raden-ayu44/embedded-systems-finpro/pcb/gambar/pcb-3d-atas-hgd-v1.png

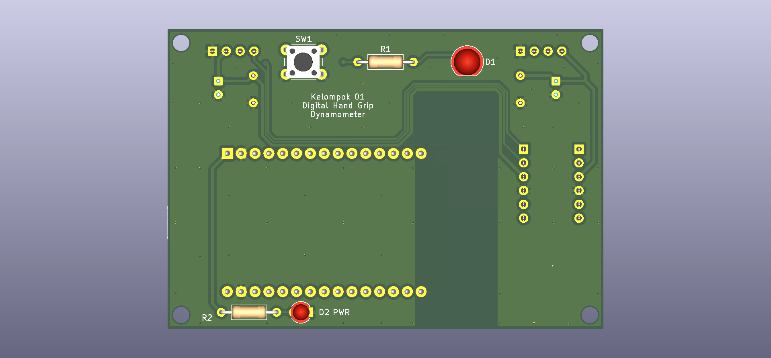
pcb/gambar/pcb-3d-atas-hgd-v1.png
