raden-ayu44/embedded-systems-finpro/datasheet/pdf/README.md

# Datasheet PDFs

Copies of cited datasheets, kept for convenience. Rights stay with the manufacturers and publishers. Each file is cited in [`../datasheet-library.md`](../datasheet-library.md) by the code in the second column.

| File | Cited as |
|---|---|
| `CZL601_OIML_datasheet.pdf`, `CZL601_Datasheet.pdf`, `CZL601_Brochure.pdf`, `GJ_Impex_CZL-601_load_cell.pdf` | DS-LC1 (CZL 601 load cell), [6] |
| `HX711_datasheet_Avia.pdf` | DS-HX1, [2] |
| `HX711_PSoC_Creator_component_datasheet_v0_0_B.pdf` | DS-HX1, [3] |
| `SparkFun_HX711_Load_Cell_skema.pdf` | HX711 module schematic (comparison) |
| `ESP32-WROOM-32D_32U_datasheet.pdf` | DS-ESP1, [7] |
| `esp-dev-kits_ESP32-DevKitC_halaman.pdf` | DS-ESP2, [8] |
| `ESP32_series_datasheet.pdf` | [10] |
| `HS1602A_datasheet.pdf` | DS-LCD1, [12] |
| `PCF8574_PCF8574A_datasheet.pdf` | DS-I2C1, [13] |
| `Adafruit_I2C_SPI_LCD_backpack.pdf` | [14] |

Vendor listings and web pages are not included; they are listed by name in the datasheet notes.
