raden-ayu44/embedded-systems-finpro/pcb/log-kerja-kicad-hgd.md

---
title: Log Kerja KiCad - PCB hgd-v1

---

# Log Kerja KiCad - PCB hgd-v1 (v3)
**Proyek akhir - embedded system**

> Catatan langkah kerja KiCad yang dikerjakan penulis sendiri, dengan bukti hasil tiap langkah. Kolom "Pemeriksaan" berisi hasil cek oleh alat AI (Claude) terhadap berkas atau tangkapan layar; pekerjaan di KiCad seluruhnya oleh penulis. Desain: [desain-pcb-hgd.md](desain-pcb-hgd.md); berkas: [kicad/proyek/](kicad/proyek/); induk: [catatan-proyek-hgd.md](../catatan-proyek-hgd.md).

---

| # | Tanggal | Langkah | Yang dikerjakan | Hasil | Pemeriksaan |
|---|---|---|---|---|---|
| 1 | 17 Okt. 2026 | Assign Footprints (Tools > Assign Footprints) | 14 simbol diberi footprint: C1, C4 `C_Disc_D7.0mm_W2.5mm_P5.00mm`; C2, C3 `CP_Radial_D5.0mm_P2.50mm`; D1 `LED_D5.0mm`; D2 `LED_D3.0mm`; J1, J2 `PinSocket_1x04_P2.54mm_Vertical`; J3, J4 `PinSocket_1x06_P2.54mm_Vertical`; R1, R2 `R_Axial_DIN0207_L6.3mm_D2.5mm_P10.16mm_Horizontal`; SW1 `SW_PUSH_6mm_H13mm`; U2 `ESP32-DEVKIT-V1:MODULE_ESP32_DEVKIT_V1` (SnapEDA) | Semua simbol punya footprint | Cocok dengan berkas papan. BOM dari KiCad tidak memuat 2 soket betina 1x15 untuk DevKit dan modul yang dicolok (HX711, LCD + backpack, level shifter, load cell); tambahkan manual di BOM |
| 2 | 17 Okt. 2026 | ERC (Inspect > Electrical Rules Checker) | 24 tanda no-connect pada pin tak terpakai (20 pin U2; J3 dan J4 pin 5-6); `PWR_FLAG` di GND; 7 peringatan `lib_symbol_mismatch` dikecualikan | **0 error, 0 warning**, 7 pengecualian (sebelumnya 28 error, 7 warning) | Pengecualian beralasan: simbol J1-J4, C1, C4, SW1 sudah diubah (nama pin); memperbarui dari pustaka akan menghapus nama pin itu |
| 3 | 17 Okt. 2026 | Page Settings skema (File > Page Settings) | Title "Hand Grip Dynamometer", Company "Kelompok 01", Revision 1, Issue Date 2026-10-17 | Title block terisi; berkas skema di repo diperbarui | Tidak ada nama orang dan jalur lokal di berkas skema |
| 4 | 17 Okt. 2026 | Simpan skema ke repo | Berkas `hgd-v1.kicad_sch` hasil langkah 1-3 disimpan dan diserahkan untuk repo | [kicad/proyek/hgd-v1.kicad_sch](kicad/proyek/hgd-v1.kicad_sch) di PR #5 (commit oleh Claude) | Berkas sama dengan yang diserahkan; tanpa jalur lokal |
| 5 | 17 Okt. 2026 | Plot Gerber dan bor (File > Fabrication Outputs) | **Plot:** format Gerber, folder `gerber\`; lapis F.Cu, B.Cu, F.Silkscreen, B.Silkscreen, F.Mask, B.Mask, Edge.Cuts; opsi umum: Subtract soldermask from silkscreen, Indicate DNP (cross-out), Check zone fills before plotting, tanpa drawing sheet, skala 1:1; opsi Gerber: Use Protel filename extensions, Generate Gerber job file, format koordinat 4.6 (mm), Use extended X2 format, Include netlist attributes. **Bor:** Excellon, metrik (mm), desimal, absolut; PTH dan NPTH di berkas terpisah; peta bor PDF | 12 berkas (19:44-19:45): 7 Gerber, job file (Revision 1), `PTH.drl`, `NPTH.drl`, 2 peta bor PDF; DRC 0 pelanggaran, 4 pengecualian | Outline 80 x 55 mm; 129 PTH (70 kaki komponen, 59 via), 4 NPTH Ø3,0; pour GND di kedua lapis, area antena kosong; silkscreen tim ada; tanpa jalur lokal. Belum dicek di viewer fabrikator |
| 6 | 17 Okt. 2026 | Cek di viewer fabrikator (JLCPCB, juga ekspor SVG viewer PCBWay) | ZIP Gerber diunggah ke penawaran daring JLCPCB (tanpa memesan); pratinjau atas dan bawah diperiksa; SVG lapis dari viewer PCBWay diunduh | JLCPCB: "Detected 2 layer board of 55x80mm", dimensi 80 x 55, 2 lapis, FR-4. Pratinjau sama dengan papan: outline persegi, H1-H4, baris DevKit dan J1-J4, pour GND kedua sisi dengan jalur antena kosong, silkscreen tim dan D2 PWR terbaca | Pratinjau cocok dengan berkas papan; viewBox SVG PCBWay 80 x 55 mm pada koordinat papan yang sama |
| 7 | 17 Okt. 2026 | Title block papan, salinan 3D, dan ekspor STEP | Page Settings papan diisi (Title, Company, Revision 1, tanggal); salinan `hgd-v1-verbatim.kicad_pcb` dengan dua soket 1x15 di pad U2; STEP diekspor dari salinan itu (File > Export > STEP) | `hgd-v1.kicad_pcb`, `hgd-v1-verbatim.kicad_pcb`, `hgd-v1.step` di [kicad/proyek/](kicad/proyek/) | Berkas papan utama hanya berbeda di title block dari versi sebelumnya; tanpa jalur lokal di ketiga berkas. Salinan verbatim punya lubang ganda di pad U2, jadi Gerber tetap dari `hgd-v1.kicad_pcb` |
| 8 | 26 Okt. 2026 | Assign Footprints, tangkapan layar | Jendela Assign Footprints dibuka lagi dan ditangkap | 14 penetapan sama dengan langkah 1; tangkapan [gambar/assign-footprint-hgd-v1.png](gambar/assign-footprint-hgd-v1.png), daftar teks di Bagian 8.1a [desain-pcb-hgd.md](desain-pcb-hgd.md) | Cocok dengan footprint di berkas papan |
| 9 | 18-19 Okt. 2026 | Judul dan silkscreen tim | Teks silkscreen tim di sisi atas dan bawah menjadi "Kelompok 01 / Digital Hand Grip / Dynamometer" (sama dengan judul proposal); Page Settings skema dan papan: Title "Digital Hand Grip Dynamometer", Company "Kelompok 01", Revision 1 tetap (tanggal di title block: skema 2026-10-19, papan 2026-10-26) | Title block dan silkscreen diperbarui | Skema hanya berubah di title block (judul dan tanggal); rangkaian dan netlist sama dengan 17 Okt. |
| 10 | 26 Okt. 2026 | ERC ulang dan PDF skema | ERC dijalankan lagi; skema dicetak ke PDF | **0 error, 0 warning**, 7 pengecualian (sama dengan langkah 2); tangkapan [gambar/erc-skema-hgd-v1.png](gambar/erc-skema-hgd-v1.png); PDF [kicad/pdf/skema-hgd-v1.pdf](kicad/pdf/skema-hgd-v1.pdf) | Metadata PDF tanpa nama orang (judul "Print Schematic", penulis kosong) |
| 11 | 26 Okt. 2026 | Belokan 45°, via, stackup | Tiga belokan siku (90°) di tengah jalur dibuat 45° (satu di jalur GND, sulit terlihat karena warnanya menyatu dengan pour); beberapa via digeser menjauhi tepi papan setelah cek JLCDFM (langkah 13); stackup papan diisi (FR4, 1,6 mm, tembaga 35 µm); DRC diulang | DRC: **0 error, 0 warning**, 3 pengecualian (footprint U2, C2, C3 berbeda dari salinan pustaka), 0 tak tersambung, 0 beda skema; 5 uji diabaikan. Tangkapan [gambar/drc-pcb-hgd-v1.png](gambar/drc-pcb-hgd-v1.png), [gambar/drc-uji-diabaikan-hgd-v1.png](gambar/drc-uji-diabaikan-hgd-v1.png) | Posisi 18 footprint sama dengan 17 Okt.; dibanding berkas 17 Okt. (termasuk perubahan langkah 9): segmen jalur 200 → 186; via 59 → 58 (56 GND + 2 sinyal). Empat sudut 90° yang tersisa tepat di pad. Pengecualian spoke thermal pad 2 U2 (langkah 5) tidak ada lagi |
| 12 | 26 Okt. 2026 | Plot Gerber dan bor ulang | Setelan sama dengan langkah 5 (KiCad 10.0.6), ZIP `Gerber_Kelompok-01_hgd-v1.zip` | 12 berkas (20:35): 7 Gerber, job file (Revision 1), `PTH.drl`, `NPTH.drl`, 2 peta bor PDF; ukuran di job file 80,05 x 55,05 mm (termasuk tebal garis outline), 2 lapis, 1,6 mm; aturan desain: jalur minimum 0,3 mm, jarak pad/jalur 0,2 mm, jarak ke pour 0,5 mm | Folder keluaran di berkas papan dan proyek menunjuk folder lokal di luar repo; di salinan repo dikembalikan ke `gerber/`. Gerber belum masuk repo (menunggu persetujuan) |
| 13 | 26 Okt. 2026 | Cek DFM di JLCDFM | ZIP Gerber diunggah ke viewer JLCDFM, analisis DFM dijalankan, laporan PDF diunduh | Terbaca 2 lapis, 80 x 55 mm; 0 sudut tajam; jarak antarjalur minimum 0,2 mm (baik); cincin tembaga lubang 0,25 mm (baik); solder mask dan lubang bor tanpa masalah. Silkscreen: 5 "bahaya" + 2 peringatan jarak tulisan ke pad (minimum 0,09 mm) dan 80 peringatan tebal garis tulisan (0,12 mm), dari garis bawaan footprint pustaka KiCad, bukan tulisan tim; tidak memengaruhi fungsi listrik | Dicek sebelum dan sesudah perbaikan langkah 11. Pratinjau sama dengan papan (outline, H1-H4, soket, silkscreen). Tangkapan dan laporan disimpan di luar repo |
| 14 | 26 Okt. 2026 | Render papan dan 3D | Tampak atas dan bawah, papan saja dan model 3D | [gambar/pcb-atas-hgd-v1.png](gambar/pcb-atas-hgd-v1.png), [pcb-bawah](gambar/pcb-bawah-hgd-v1.png), [3D atas](gambar/pcb-3d-atas-hgd-v1.png), [3D bawah](gambar/pcb-3d-bawah-hgd-v1.png) | STEP 26 Okt. diekspor dari papan utama, jadi tanpa dua soket 1x15 DevKit; soket tidak memengaruhi desain housing, jadi STEP ini menggantikan `hgd-v1.step` lama dan salinan `hgd-v1-verbatim.kicad_pcb` dihapus (27 Okt. 2026) |
| 15 | 27 Okt. 2026 | Gambar penempatan diperbarui | Gambar SVG tiga panel (gabungan, F.Cu, B.Cu + silkscreen bawah) dibuat ulang dari berkas papan 26 Okt. oleh alat AI (Claude); keterangan ditulis dalam bahasa Indonesia, istilah teknis dalam bahasa Inggris | [gambar/penempatan-pcb-hgd.svg](gambar/penempatan-pcb-hgd.svg) | Dicek terhadap `hgd-v1.kicad_pcb`: 186 segmen jalur (posisi, lapis, lebar), 58 via, 70 pad, 4 NPTH, dan teks silkscreen kedua sisi sama dengan berkas |
| 16 | 12 Nov. 2026 | Perbaikan silkscreen footprint dan D2 | Garis silkscreen footprint pustaka yang terlalu dekat pad dihapus (D1: lingkaran; D2: 2 garis, 2 busur; R1, R2: 2 garis masing-masing); D2 digeser 0,52 mm ke kanan dengan dua segmen jalur GND ke katodenya; tiga via jahit GND di tepi bawah digeser; uji `lib_footprint_mismatch` dan `lib_symbol_mismatch` diatur Ignore (pengecualian lama dihapus) | `hgd-v1.kicad_pcb`, `hgd-v1.kicad_pro` di [kicad/proyek/](kicad/proyek/) | Dibanding papan 26 Okt.: 18 footprint, hanya D2 berpindah (x 135,50 → 136,02); 186 segmen (2 berubah), 58 via (3 berpindah), pad lain dan Edge.Cuts sama. DRC ulang (kicad-cli): 0 pelanggaran, 0 tak tersambung, 0 beda skema; ERC ulang: 0 error, 0 warning. Folder keluaran di salinan repo dikembalikan ke `gerber/`, STEP ke `hgd-v1.step` |
| 17 | 12 Nov. 2026 | Plot Gerber dan bor ulang | Setelan sama dengan langkah 5 (KiCad 10.0.6), ZIP `Gerber_Kelompok-01_hgd-v1.zip` | 12 berkas (10:53): 7 Gerber, job file, `PTH.drl`, `NPTH.drl`, 2 peta bor PDF | Geometri dibandingkan dengan ekspor kicad-cli dari berkas papan yang sama: tembaga, mask, silkscreen, Edge.Cuts, 128 PTH, dan 4 NPTH sama (beda hanya nomor aperture dan waktu) |
| 18 | 12 Nov. 2026 | Cek DFM di JLCDFM | ZIP Gerber 12 Nov. diunggah, analisis DFM dijalankan, laporan PDF diunduh | 2 lapis, 8 x 5,5 cm; sudut tajam 0; jarak antarjalur 0,2 mm (baik); cincin tembaga 0,25 mm (baik); soldermask dan bor 0 temuan; silkscreen ke pad **0 temuan** (minimum 0,19 mm; 26 Okt.: 5 bahaya + 2 peringatan, minimum 0,09 mm); tebal garis silkscreen 76 peringatan (0,12 mm; 26 Okt.: 80) | Laporan disimpan di luar repo. Sisa peringatan tebal garis dari garis footprint pustaka, tidak memengaruhi fungsi listrik |

---

## Perubahan

| Versi | Tanggal | Perubahan |
|---|---|---|
| v3 | 12 Nov. 2026 | Langkah 16-18 (12 Nov. 2026): silkscreen footprint dirapikan, D2 digeser, uji beda-pustaka diatur ignore, Gerber ulang, cek JLCDFM |
| v2 | 27 Okt. 2026 | Langkah 8-14 (26 Okt. 2026): tangkapan Assign Footprints, judul dan silkscreen baru, ERC ulang dan PDF skema, belokan 45° dan stackup, Gerber ulang, cek JLCDFM, render; STEP baru menggantikan STEP dan salinan verbatim 17 Okt.; langkah 15 (27 Okt.): gambar penempatan papan akhir |
| v1 | 17 Okt. 2026 | Log pertama: langkah 1-7 |
