raden-ayu44/embedded-systems-finpro/sitasi/sitasi-hgd.md

---
title: Sitasi dan Daftar Pustaka - Hand Grip Dynamometer

---

# Sitasi dan Daftar Pustaka - Hand Grip Dynamometer (v1)
**Proyek akhir - embedded system**

> Teori buku dan temuan paper yang menjadi dasar keputusan, kode sitasi lokal, dan daftar pustaka gaya IEEE. Kode (M1, W1, V1, dst.) dipakai di semua dokumen proyek. Induk: [catatan-proyek-hgd.md](../catatan-proyek-hgd.md).

---

## 1. LIBRARY SITASI - TEORI BUKU & TEMUAN PAPER

*Parafrase setia (bukan kutipan verbatim) dari kedua buku teks, diterjemahkan ke Indonesia dengan analogi di beberapa titik. Temuan paper diinterpretasi. Cakupan dibatasi pada yang benar-benar jadi fondasi keputusan di dokumen ini - bagian buku/paper yang dibaca tapi tidak dipakai (misal fitur game Gotthelf, sensor FSR/IMU Becerra, amplifier AD627) sengaja tidak dimasukkan di sini (lihat Bagian 3 di [catatan-proyek-hgd.md](../catatan-proyek-hgd.md) untuk catatan "TIDAK diadopsi"-nya).*

**Konvensi sitasi lokal:** kode di kolom pertama tabel di bawah (M1, W1, V1, dst.) dipakai sebagai sitasi `(kode)` di seluruh dokumen proyek ini - ditulis menempel setelah klaim yang didukungnya, gaya IEEE. **Sistem ini TIDAK universal** - kode ini cuma berlaku di dokumen proyek ini sendiri, tidak bisa dipakai/dikenali di dokumen lain (beda dari sitasi [1], [2] ala panduan yang merujuk Daftar Pustaka baku). Kalau bagian dari catatan ini disalin ke dokumen formal nanti, kode `(kode)` ini perlu ditulis ulang jadi sitasi format resmi (APA/IEEE sesuai ketentuan dosen) merujuk ke daftar pustaka yang sebenarnya - bukan dibiarkan sebagai kode internal ini.

### 1.1 Marwedel, *Embedded System Design* (ed. 4, 2021)

| Kode | Isi (parafrase) | Asal |
|---|---|---|
| M1 | Statechart memperluas FSM datar dengan dua kemampuan: (a) state hierarkis - satu "superstate" bisa membungkus beberapa state di dalamnya, dan (b) orthogonal region - beberapa state bisa aktif bersamaan secara paralel. Transisi bisa digambar dari batas superstate itu sendiri (bukan dari tiap state anak satu-satu) dan otomatis berlaku untuk seluruh state di dalamnya - disebut interrupt transition. Analogi: seperti aturan "kalau alarm kebakaran berbunyi, semua orang di gedung keluar" - tidak perlu aturan terpisah per lantai/ruangan, cukup satu aturan di level gedung. | Bab 2, §2.4 Communicating Finite State Machines, §2.4.2 StateCharts |
| M2 | Embedded system didefinisikan sebagai sistem pemrosesan informasi yang tertanam ke dalam produk yang membungkusnya (bukan berdiri sendiri sebagai komputer umum). Tabel 1.2 membandingkan lewat 4 kriteria: arsitektur (kompak-heterogen vs tidak kompak-homogen), tujuan optimasi (energi/ukuran vs performa rata-rata), relevansi real-time (sering penting vs jarang), dan safety-critical (mungkin vs biasanya tidak). | Bab 1, Definisi 1.1 & Tabel 1.2 |
| M3 | Sensor mengubah besaran fisik (di sini: gaya tekan) jadi sinyal listrik analog. Karena sinyal analog kontinu tapi mikrokontroler memproses secara diskrit, dibutuhkan dua tahap diskritisasi: sample-and-hold (menangkap nilai sinyal pada satu momen dan menahannya stabil sesaat), lalu ADC (mengubah nilai yang ditahan itu jadi angka digital). Analogi: seperti memfoto air yang mengalir - kamera "menahan" satu momen (sample-and-hold) sebelum dicetak jadi gambar diam (ADC). | Bab 3, §3.2.1 Sensors, §3.2.2 Sample-and-Hold, §3.2.4 ADC |
| M4 | Kebalikan dari ADC - DAC mengubah sinyal digital jadi analog untuk menggerakkan aktuator. PWM adalah alternatif lebih murah dari DAC asli: sinyal digital dinyalakan-matikan sangat cepat dengan rasio (duty cycle) tertentu, dan secara rata-rata "terasa" seperti tegangan analog di antara 0 dan penuh oleh perangkat penerima (motor, mata manusia untuk LED). | Bab 3, §3.6.1 DAC, §3.6.3 Pulse-Width Modulation, §3.6.4 Actuators |
| M5 | Metrik kuantitatif seberapa jauh nilai hasil pengukuran menyimpang dari nilai sebenarnya: MAE (rata-rata selisih absolut), MSE (rata-rata selisih kuadrat - menghukum error besar lebih berat), RMSE (akar dari MSE, kembali ke satuan asli sehingga mudah diinterpretasi), SNR/PSNR (rasio sinyal terhadap noise). | Bab 5, §5.3 Quality Metrics |
| M6 | Dua metode analisis risiko formal. FMEA bekerja dari bawah ke atas: mendaftar tiap kemungkinan cara komponen gagal (mode kegagalan), efeknya ke sistem, lalu tingkat keparahan. FTA bekerja dari atas ke bawah: mulai dari satu kegagalan sistem yang tidak diinginkan, menelusuri kombinasi kegagalan komponen yang bisa menyebabkannya (pohon logika AND/OR). | Bab 5, §5.6.5 Fault Tree Analysis, Failure Mode, and Effect Analysis |

### 1.2 White, *Making Embedded Systems* (ed. 1, 2011) - rujukan panduan [3]

| Kode | Isi (parafrase) | Asal |
|---|---|---|
| W1 | Kontak tombol mekanik tidak berubah bersih dari 0 ke 1 saat ditekan - fisiknya bergetar (bouncing) beberapa milidetik, menyebabkan pembacaan digital berubah cepat berkali-kali padahal cuma satu tekanan. Solusi debounce software: catat waktu tiap kali sinyal berubah, abaikan perubahan berikutnya kalau terjadi dalam jendela waktu terlalu singkat sejak perubahan terakhir (dianggap bouncing, bukan tekanan baru). | Bab 4, "Momentary Button Press" |
| W2 | Pola desain di mana logika penanganan error (deteksi, pencatatan, pemulihan) dikumpulkan jadi satu modul/fungsi yang dipanggil dari berbagai titik program yang membutuhkan, alih-alih ditulis berulang di tiap tempat kode yang bisa gagal. Manfaat: konsistensi penanganan error di seluruh sistem, perubahan cukup di satu tempat kalau kebijakan error berubah. | Bab 3, "Dealing with Errors" - Error Handling Library pattern |
| W3 | Lima cara mengkodekan finite state machine di C: (1) State-Centric - percabangan besar berdasarkan state aktif; (2) State-Centric with Hidden Transitions - varian dengan transisi disembunyikan di dalam fungsi state; (3) Event-Centric - percabangan berdasarkan event masuk, bukan state aktif; (4) State Pattern - satu objek/struct per state dengan fungsi seragam (gaya OOP); (5) Table-Driven - tabel data yang memetakan (state saat ini + event) ke (state berikutnya + aksi), dieksekusi satu "engine" generik yang sama untuk semua state. Penulis merekomendasikan table-driven karena engine-nya reusable dan tiap baris tabel gampang diuji terpisah. | Bab 5, "State Machines" & "Choosing a State Machine Implementation" |
| W4 | Timer hardware terpisah dari prosesor utama yang me-reset sistem kalau tidak menerima sinyal "sistem sehat" ("kick"/"pet the dog") dalam batas waktu tertentu. Menangani kegagalan yang TIDAK bisa dipulihkan software sendiri (macet total/infinite loop) - bukan pengganti error handling normal. Tiga pola pemberian sinyal yang salah: (a) dari timer interrupt terpisah - membatalkan tujuan watchdog karena sistem tidak pernah reset walau macet; (b) di dalam fungsi delay - sinyal tersebar, area tanpa delay tidak terpantau; (c) disebar di banyak fungsi panjang - melemahkan pengawasan. Rekomendasi: satu titik sinyal saja, idealnya di ujung main loop. | Bab 5, "Watchdog" |
| W5 | Struktur data array berukuran tetap yang "melingkar" - begitu penuh, data baru menimpa data terlama. Cocok menyimpan N sampel terakhir dengan memori terprediksi dan konstan, tanpa menggeser seluruh isi array tiap ada data baru. | Bab 6, "Circular Buffers" |
| W6 | Dua pendekatan menghitung rata-rata data yang terus mengalir: cumulative average (rata-rata berjalan, diperbarui lewat rumus incremental tanpa menyimpan seluruh riwayat - hemat memori) versus menyimpan beberapa sampel terakhir lalu dirata-rata/dicari mediannya sekali di akhir (median lebih tahan outlier/noise ekstrem, tapi butuh memori menyimpan sampel). | Bab 9, "Taking an Average" & "Different Averages: Cumulative and Median" |
| W7 | Dua gaya arsitektur sistem embedded. Event-driven: sistem diam menunggu kejadian (interrupt, tombol) lalu bereaksi sesaat, kembali diam. Data-driven: sistem memproses aliran data yang datang terus-menerus (misal dari sensor) secara berulang. Kebanyakan sistem nyata adalah campuran keduanya - penulis menyarankan memisahkan dengan jelas bagian mana tergolong mana dalam satu desain. | Bab 6, "Data Handling" |

### 1.3 Vaishya et al. 2024 (J Health Pop & Nutrition)

| Kode | Isi (interpretasi) | Asal |
|---|---|---|
| V1 | Protokol pengukuran standar (Box 1): posisi duduk, bahu netral, siku ditekuk 90°, pergelangan tangan 0-30° dorsofleksi; kalibrasi alat sebelum mulai; instruksi verbal ke partisipan "remas sekuat dan selama mungkin sampai saya bilang berhenti (ketika jarum berhenti naik)"; tahan 3-5 detik; istirahat ~1 menit antar percobaan; 3 kali percobaan bergantian tangan. | Box 1 |
| V2 | Nilai klinis HGS datang dari pengukuran berulang dari waktu ke waktu untuk melihat tren, bukan dari satu kali pembacaan tunggal. | Bagian pembahasan utama |
| V3 | Relative HGS = HGS dibagi BMI, untuk menormalisasi perbedaan ukuran tubuh antar individu saat membandingkan kekuatan genggam. | Bagian pembahasan utama |
| V4 | Ambang "lemah" (sarkopenia) untuk HGS menurut berbagai badan kesehatan: EWGSOP2 (Eropa) <27kg pria/<16kg wanita; AWGS (Asia) <28kg pria/<18kg wanita; India (Sarco-CUBES) <27,5kg pria/<18kg wanita. Populasi sehat pada umumnya berada jauh di atas ambang ini. | Tabel 1 |

### 1.4 Ramadhani et al. 2019 (IJEEEMI)

| Kode | Isi (interpretasi) | Asal |
|---|---|---|
| R1 | Arsitektur: Arduino Uno + HX711 (amplifier sinyal + ADC 24-bit) + load cell tipe batang + LCD karakter 16x2 + indikator tingkat kekuatan (lemah/sedang/kuat). | Bagian II (Materials and Methods) & III (Block Diagram) |
| R2 | Device ini tidak mendeteksi kapan genggaman "selesai" secara otomatis - nilai puncak terus dilacak selama alat menyala, direset hanya lewat tombol manual terpisah. | Bagian III.A (kode program) |
| R3 | Load cell batang kapasitas 50kg dipilih untuk mengukur kekuatan genggam pasien pasca-stroke (populasi dengan kekuatan genggam sudah menurun akibat kondisi medis). | Bagian II.A |

### 1.5 Gotthelf et al. 2021 (J NeuroEng Rehab)

| Kode | Isi (interpretasi) | Asal |
|---|---|---|
| G1 | Dari 237 partisipan (usia 6-30), kekuatan genggam individu tertinggi tercatat sampai 764N (~78kgf) di kelompok usia 30-34, dan sampai 581N (~59kgf) di kelompok usia 20-24 (laki-laki). | Tabel 1 |
| G2 | Protokol permainan (Rocket Launch) memakai jendela waktu tetap (5 detik kalibrasi, 15 detik tracking) untuk menentukan kapan satu fase pengukuran berakhir - bukan berdasarkan nilai gaya turun di bawah suatu ambang. | Bagian Methods (Hand grip system) |
| G3 | Fase kalibrasi MVC (mengukur kekuatan maksimal) disampaikan ke partisipan sebagai instruksi permainan ("luncurkan roket"), bukan sebagai prosedur kalibrasi teknis yang terasa formal. | Bagian Methods |

### 1.6 Becerra et al. 2021 (Applied Sciences, UIB)

| Kode | Isi (interpretasi) | Asal |
|---|---|---|
| B1 | Interface pengujian menampilkan gaya maksimum + gaya saat ini secara numerik, status tiap sensor jari, orientasi tangan (representasi 3D), dan grafik riwayat gaya dalam satu sesi - kombinasi elemen visual real-time, bukan cuma satu angka. | Bagian 2.2.3 (Client Application) & Gambar 6 |

### 1.7 Chang & Chen 2015 (Bio-Med Mat & Eng, Taiwan)

| Kode | Isi (interpretasi) | Asal |
|---|---|---|
| C1 | Load cell dipilih dengan kapasitas jauh di atas kekuatan genggam maksimum yang diharapkan dari populasi target (136kg untuk mengukur populasi dengan grip <100kg) - memberi margin aman tanpa risiko saturasi. | Bagian 2 (Experimental Details) |
| C2 | Dynamometer digital terintegrasi menyimpan data pengukuran otomatis ke komputer, mengatasi kelemahan dynamometer analog tradisional (seperti JAMAR) yang mengharuskan pencatat menyalin nilai manual satu per satu - rawan human error dan kehilangan data. | Bagian 1 (Introduction) |

### 1.8 Russell, *Introduction to Embedded Systems Using ANSI C and the Arduino Development Environment* (2010) - rujukan panduan [1]

*Catatan: sitasi panduan untuk buku ini akurat di Minggu 1-3 (Bab 1-2, 3-4-6, 9), tapi Minggu 4 (ADC) dan Minggu 5 (aktuator) sama-sama dikutip sebagai "Bab 10" padahal Bab 10 aslinya adalah Serial Communications - kemungkinan salah ketik di panduan. ADC yang benar ada di Bab 8, PWM/timer (aktuator) di Bab 7.*

| Kode | Isi (parafrase) | Asal |
|---|---|---|
| RU1 | ISR (kode yang jalan saat interrupt terjadi) tidak bisa berkomunikasi ke program utama lewat parameter/return value biasa - satu-satunya jalan lewat variabel bersama (shared memory). Masalahnya, satu instruksi C sebenarnya terdiri dari beberapa instruksi mesin; kalau interrupt terjadi persis di tengah proses baca/tulis suatu variabel oleh program utama, variabel itu bisa berakhir dalam kondisi "setengah lama-setengah baru" - rusak, bukan salah satu dari dua nilai yang valid. Variabel yang dibaca/ditulis ISR wajib dideklarasikan `volatile` supaya compiler tidak meng-cache nilainya seolah tidak pernah berubah dari luar. | §9.1.2 ISR and Main Task Communication |
| RU2 | Pin input yang tidak disambung ke apapun (floating) punya sinyal yang "mengambang" secara elektris dan bisa memicu transisi/interrupt yang tidak diinginkan secara acak. Solusi standar: sambungkan resistor pull-up (menarik pin ke tegangan tinggi secara lemah saat tidak ada sinyal aktif) - kebanyakan mikrokontroler modern menyediakan ini secara internal, tidak perlu resistor fisik tambahan. | §6.2.2 Internal Pull-up Resistor |

### 1.9 Sumber desain housing (dipindah)

Rujukan desain housing grip (dokumentasi alat komersial KG1, GA1, VN1, BP1, PP1, SP1, WM1 dan diskusi komunitas FP1; semuanya bukan peer-review) dipindah ke [desain-housing-load-cell.md, HL18](../housing-load-cell/desain-housing-load-cell.md#hl18-sumber-rujukan-housing-bukan-peer-review) karena hanya dipakai di sana.

### 1.10 Daftar pustaka (gaya IEEE)

Daftar ini melengkapi sitasi lokal di atas: kode lokal (M, W, V, R, G, B, C, RU, BJ) tetap dipakai di badan teks, dan tabel di bawah memetakan tiap kelompok kode ke entri IEEE. Datasheet komponen (DS-*) memakai daftar IEEE sendiri di `datasheets/datasheet-library.md` ([1] sampai [16]); sumber desain housing (KG1 dan seterusnya) ada di `desain-housing-load-cell.md`, HL18.

| Kode lokal | Entri IEEE |
|---|---|
| M1 sampai M6 | [1] |
| W1 sampai W7 | [2] |
| V1 sampai V4 | [3] |
| R1 sampai R3 | [4] |
| G1 sampai G3 | [5] |
| B1 dan seterusnya | [6] |
| C1 dan C2 | [7] |
| RU1 dan RU2 | [8] |
| BJ1 sampai BJ4 | [9] |

**Daftar pustaka**

[1] P. Marwedel, *Embedded System Design: Embedded Systems Foundations of Cyber-Physical Systems, and the Internet of Things*, 4th ed. Cham, Switzerland: Springer Nature, 2021.

[2] E. White, *Making Embedded Systems: Design Patterns for Great Software*, 1st ed. Sebastopol, CA, USA: O'Reilly Media, 2011.

[3] R. Vaishya, A. Misra, A. Vaish, N. Ursino, and R. D'Ambrosi, "Hand grip strength as a proposed new vital sign of health: A narrative review of evidences," *J. Health Popul. Nutr.*, vol. 43, no. 1, Art. no. 7, Jan. 2024, doi: 10.1186/s41043-024-00500-y.

[4] R. Ramadhani, E. D. Setioningsih, and T. Hamzah, "Hand grip measure device post-stroke patients," *Int. J. Electron. Eng. Med. Inform. (IJEEMI)*, vol. 1, no. 2, pp. 60-63, Nov. 2019, doi: 10.35882/ijeeemi.v1i2.3.

[5] O. Gotthelf, D. Townsend, and W. Durfee, "A video game based hand grip system for measuring muscle force in children," *J. NeuroEng. Rehabil.*, vol. 18, no. 1, Art. no. 113, Jul. 2021, doi: 10.1186/s12984-021-00908-1.

[6] V. Becerra, F. J. Perales, M. Roca, J. M. Buades, and M. Miro-Julia, "A wireless hand grip device for motion and force analysis," *Appl. Sci.*, vol. 11, no. 13, Art. no. 6036, Jun. 2021, doi: 10.3390/app11136036.

[7] H. Chang, C.-H. Chen, T.-S. Huang, and C.-Y. Tai, "Development of an integrated digital hand grip dynamometer and norm of hand grip strength," *Biomed. Mater. Eng.*, vol. 26, no. s1, pp. S611-S617, 2015, doi: 10.3233/BME-151352.

[8] D. J. Russell, *Introduction to Embedded Systems: Using ANSI C and the Arduino Development Environment*, Synthesis Lectures on Digital Circuits and Systems. San Rafael, CA, USA: Morgan & Claypool, 2010.

[9] F. P. Beer, E. R. Johnston, Jr., and J. T. DeWolf, *Mechanics of Materials*, 3rd ed. New York, NY, USA: McGraw-Hill, 2002, ch. 5, "Analysis and Design of Beams for Bending." Slide kuliah pendamping oleh J. W. Oler.

*Catatan: entri [4] memakai tahun dan bulan yang tercetak pada PDF artikel (Vol. 1, No. 2, November 2019). Entri [8] (penerbit dan kota) ditulis dari pengetahuan umum, belum dicocokkan dengan salinan buku; cek halaman judul bukunya.*

### 1.11 Beer, Johnston, dan DeWolf, *Mechanics of Materials* (ed. 3, 2002), Bab 5

Dipakai untuk hitungan gaya housing grip ([desain-housing-load-cell.md, HL9](../housing-load-cell/desain-housing-load-cell.md#hl9-temuan-kekakuan-batang-dan-usulan-bahan)).

| Kode | Isi (parafrase) | Asal |
|---|---|---|
| BJ1 | Analisis balok dimulai dengan memperlakukan seluruh balok sebagai benda tegar untuk mencari gaya reaksi tumpuan (ΣF = 0, ΣM = 0), lalu memotong balok di dekat tumpuan dan titik beban untuk mencari gaya geser V dan momen lentur M di tiap potongan. | Bab 5, Sample Problem 5.1 dan 5.2 |
| BJ2 | Hubungan beban, geser, dan momen: dV/dx = −w dan dM/dx = V. Perubahan momen antara dua titik sama dengan luas di bawah diagram geser; momen berubah linear di antara beban terpusat dan kuadratik di bawah beban merata. | Bab 5, "Relations Among Load, Shear, and Bending Moment", Sample Problem 5.3 |
| BJ3 | Tegangan normal akibat lentur terbesar di permukaan, di penampang dengan momen terbesar: σ_m = M/S, dengan S = I/c; untuk penampang persegi panjang S = b·h²/6. | Bab 5, "Introduction", Sample Problem 5.1 |
| BJ4 | Desain aman mensyaratkan σ_m di bawah tegangan izin, sehingga modulus penampang minimum S_min = M_maks/σ_izin; dari pilihan yang memenuhi S_min, pilih yang paling ringan. | Bab 5, "Design of Prismatic Beams for Bending", Sample Problem 5.8 |

---

## 2. TOPIK YANG MASIH BUTUH SUMBER

> Topik di alur program yang bertanda `[sitasi]` dan belum punya sumber. Kolom sumber diisi dari daftar pustaka di Bagian 1 setelah dipilih.

| Tanda | Topik yang butuh sumber | Sumber |
|---|---|---|
| (kosong) | Nilai klinis HGS dari pengukuran berulang | - |
| (kosong) | Kelemahan dynamometer tanpa pencatatan otomatis | - |
| (kosong) | Protokol pengukuran standar HGS | - |
| (kosong) | Gaya genggam tertinggi di literatur | - |
| (kosong) | Statechart / FSM hierarkis dan interrupt transition | - |
| (kosong) | Debounce, pull-up, `volatile`, akses ISR-loop | - |
| (kosong) | State machine berbasis tabel; pola penanganan galat; watchdog; buffer melingkar; rata-rata/median | - |
| (kosong) | Event-driven vs data-driven | - |
| (kosong) | Metrik RMSE/MAE | - |
