raden-ayu44/embedded-systems-finpro/sitasi/pdf/README.md

# Paper PDFs

Open-access papers and one patent, kept for convenience. Rights stay with the publishers. Cited in [`../sitasi-hgd.md`](../sitasi-hgd.md) by the local code in the second column.

| File | Cited as | License |
|---|---|---|
| `Vaishya_2024_JHPN.pdf` | V1–V4 | CC BY 4.0 |
| `Gotthelf_2021_JNER.pdf` | G1–G3 | CC BY 4.0 |
| `Becerra_2021_ApplSci.pdf` | B1 | MDPI open access |
| `ChangChen_2015_BME.pdf` | C1–C2 | CC BY-NC (open access) |
| `Paten_US9857261.pdf` | housing reference | US patent |

Textbooks and papers without an open license are not included.
