raden-ayu44/embedded-systems-finpro/pcb/gambar/assign-footprint-hgd-v1.png

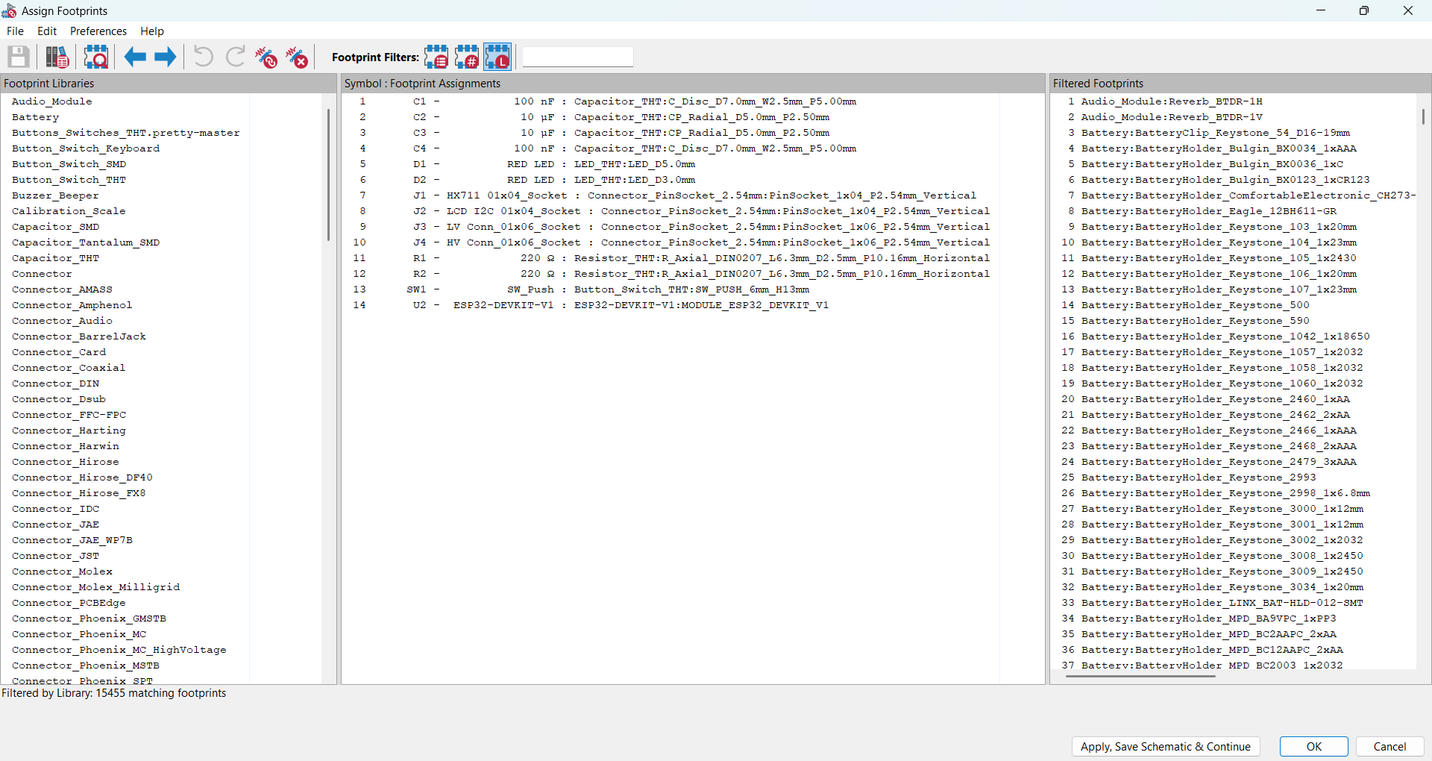
pcb/gambar/assign-footprint-hgd-v1.png
