raden-ayu44/embedded-systems-finpro/pcb/gambar/drc-pcb-hgd-v1.png

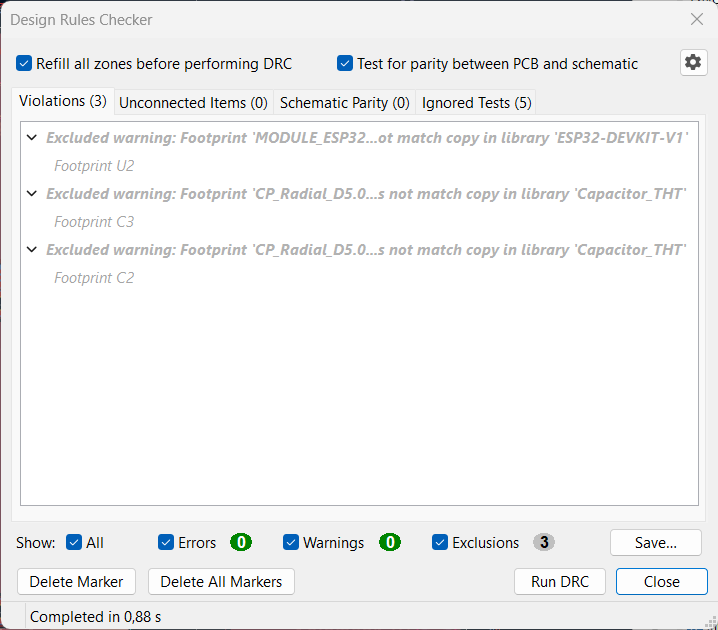
pcb/gambar/drc-pcb-hgd-v1.png
