raden-ayu44/embedded-systems-finpro/pcb/pcb_netlist.xlsx

Sheet: Netlist
Net | Fungsi | Pin | Jumlah pin
+3V3 | Rail logika 3,3 V dari regulator papan ESP32 (KiCad: Net-(J1-VCC)) | U2.1 (3V3), J1.4, J3.3 (LV), C1.1, C2.+ | 5
+5V | Rail 5 V dari VIN (USB) untuk LCD dan sisi HV shifter (KiCad: Net-(J2-VCC)) | U2.30 (VIN), J2.2, J4.3 (HV), C3.+, C4.1 | 5
GND | Ground bersama (pour tembaga) | U2.2, U2.29, J1.1, J2.1, J3.4, J4.4, SW1.2, D1.K, C1.2, C2.-, C3.-, C4.2 | 12
HX_DT | HX711 DOUT, GPIO18 (KiCad: Net-(J1-DT)) | U2.9 (GPIO18), J1.2 | 2
HX_SCK | HX711 SCK, GPIO19 (KiCad: Net-(J1-SCK)) | U2.10 (GPIO19), J1.3 | 2
SDA_3V3 | I2C SDA sisi ESP32, GPIO21 (KiCad: Net-(J3-LV1)) | U2.11 (GPIO21), J3.1 (LV1) | 2
SCL_3V3 | I2C SCL sisi ESP32, GPIO22 (KiCad: Net-(J3-LV2)) | U2.14 (GPIO22), J3.2 (LV2) | 2
SDA_5V | I2C SDA sisi LCD (KiCad: Net-(J2-SDA)) | J4.1 (HV1), J2.3 | 2
SCL_5V | I2C SCL sisi LCD (KiCad: Net-(J2-SCL)) | J4.2 (HV2), J2.4 | 2
BTN | Tombol, GPIO25 (pull-up internal, interrupt) (KiCad: Net-(U2-D25)) | U2.23 (GPIO25), SW1.1 | 2
LED_DRV | Keluaran GPIO27 ke resistor (KiCad: Net-(U2-D27)) | U2.25 (GPIO27), R1.1 | 2
LED_A | Resistor ke anoda LED (KiCad: Net-(D1-A)) | R1.2, D1.A | 2
(tidak dipakai) | Kanal 3-4 level shifter | J3.5, J3.6, J4.5, J4.6 | 4
Netlist dari skema KiCad hgd-v1, diperiksa 15 Okt. 2026 (kedua GND U2.2 dan U2.29 ikut). Nomor pin U2 = nomor pin header DevKit (1 = 3V3, 15 = D23, 16 = EN, 30 = VIN).

Sheet: Komponen
Ref | Nama umum | Nama part resmi (sesuai datasheet bila ada) | Simbol KiCad (skema) | Footprint KiCad | Jumlah | Fungsi | Catatan / status | Referensi
U2 | ESP32 DevKit V1 30 pin | Papan: DOIT ESP32 DevKit V1; modul: ESP32-WROOM-32D (Espressif) | ESP32-DEVKIT-V1 (SnapEDA) | ESP32-DEVKIT-V1:MODULE_ESP32_DEVKIT_V1 (SnapEDA, oleh "Do it") | 1 | Mikrokontroler; dicolok ke dua soket betina 1x15 di sisi bawah PCB | Pitch 2,54, jarak baris 25,4, bor 1,02 mm, pad 1 = 3V3, pad 16 = EN (diperiksa). Empat lubang NPTH bawaan footprint dihapus | DS-ESP1, DS-ESP2
- | Soket betina 1x15 (2 pcs) | Female pin socket 1x15, pitch 2,54 mm (generik) | - | Disolder pada pad U2 | 2 | Dudukan DevKit | Bukan footprint terpisah: hapus dua REF** PinSocket_1x15 yang menumpuk di pad U2 | DS-CON1 (opsional)
J1 | Soket betina 1x4 | Female pin socket 1x4, pitch 2,54 mm (generik) | Connector_Generic:Conn_01x04 | Connector_PinSocket_2.54mm:PinSocket_1x04_P2.54mm_Vertical | 1 | Modul HX711 dicolok langsung (GND, DT, SCK, VCC) | Sisi bawah; cocokkan urutan dengan silkscreen XFW-HX711 | DS-HX1
J2 | Soket betina 1x4 | Female pin socket 1x4, pitch 2,54 mm (generik) | Connector_Generic:Conn_01x04 | Connector_PinSocket_2.54mm:PinSocket_1x04_P2.54mm_Vertical | 1 | Backpack LCD lewat kabel F-M (GND, VCC 5 V, SDA, SCL) | Sisi bawah | DS-LCD1, DS-I2C1
J3 | Soket betina 1x6 | Female pin socket 1x6, pitch 2,54 mm (generik) | Connector_Generic:Conn_01x06 | Connector_PinSocket_2.54mm:PinSocket_1x06_P2.54mm_Vertical | 1 | Level shifter sisi LV (LV1, LV2, LV, GND, LV3, LV4) | Sisi bawah; soket tidak berkunci: tandai pin 1 dan "LV" | DS-LLS1
J4 | Soket betina 1x6 | Female pin socket 1x6, pitch 2,54 mm (generik) | Connector_Generic:Conn_01x06 | Connector_PinSocket_2.54mm:PinSocket_1x06_P2.54mm_Vertical | 1 | Level shifter sisi HV (HV1, HV2, HV, GND, HV3, HV4) | Jarak J3-J4 10,16 mm (perkiraan; ukur modul) | DS-LLS1
SW1 | Tombol tactile 6x6 mm, batang 13 mm | Tactile push button 6 x 6 mm, THT, tinggi 13 mm (generik) | Switch:SW_Push | Button_Switch_THT:SW_PUSH_6mm_H13mm | 1 | Tombol tunggal (START/NEXT/RESTART), GPIO25 | Sisi atas; menembus tutup | DS-BTN1 (belum diambil)
D1 | LED 5 mm | LED 5 mm diffused, THT (generik) | Device:LED | LED_THT:LED_D5.0mm | 1 | Indikator genggam, GPIO27 | Sisi atas | DS-LED1 (belum diambil)
R1 | Resistor 220 ohm | Resistor 220 ohm, axial, 1/4 W (generik) | Device:R | Resistor_THT:R_Axial_DIN0207_L6.3mm_D2.5mm_P10.16mm_Horizontal | 1 | Pembatas arus LED | Sekitar 6 mA pada Vf 2,0 V; sisi atas | DS-RES1 (opsional)
C1 | Kapasitor keramik 100 nF | Ceramic capacitor 100 nF (generik) | Device:C | Capacitor_THT:C_Disc_D7.0mm_W2.5mm_P5.00mm | 1 | Decoupling +3V3 dekat J1 (HX711) | Sisi bawah; komponen lab | DS-CAP1 (opsional)
C2 | Kapasitor elektrolit 10 uF | Aluminium electrolytic capacitor 10 uF, 6,3 V atau lebih (generik) | Device:C_Polarized | Capacitor_THT:CP_Radial_D5.0mm_P2.50mm | 1 | Bulk +3V3 dekat J1 | Sisi bawah; + ke 3V3 | DS-CAP1 (opsional)
C3 | Kapasitor elektrolit 10 uF | Aluminium electrolytic capacitor 10 uF, 6,3 V atau lebih (generik) | Device:C_Polarized | Capacitor_THT:CP_Radial_D5.0mm_P2.50mm | 1 | Bulk +5V dekat J2 (LCD) | Sisi bawah; + ke 5V | DS-CAP1 (opsional)
C4 | Kapasitor keramik 100 nF | Ceramic capacitor 100 nF (generik) | Device:C | Capacitor_THT:C_Disc_D7.0mm_W2.5mm_P5.00mm | 1 | Decoupling +5V dekat J2 | Sisi bawah | DS-CAP1 (opsional)
H1-H4 | Lubang M3 | Mounting hole M3 | Mechanical:MountingHole | MountingHole:MountingHole_3.2mm_M3 | - | Pemasangan ke housing | Posisi ditentukan setelah sisi atas; satu dekat SW1 | -
Simbol dan footprint sesuai skema KiCad hgd-v1 (15 Okt. 2026). Kredit footprint U2: SnapEDA, "ESP32-DEVKIT-V1" oleh "Do it".

Sheet: Modul luar PCB
Ref | Nama umum | Nama part resmi (sesuai datasheet) | Simbol KiCad (skema) | Footprint KiCad | Terhubung lewat | Catatan / status | Referensi
MOD-ESP | ESP32 DevKit V1 (30 pin) | Papan: DOIT ESP32 DevKit V1; modul di papan: ESP32-WROOM-32D (Espressif) | U2 (SnapEDA) | U2 (SnapEDA) | Dua soket betina 1x15 (pad U2) | Dicolok, sisi bawah PCB | DS-ESP1, DS-ESP2
MOD-HX | Modul HX711 (penguat load cell) | Modul XFW-HX711 dengan chip HX711 (Avia Semiconductor) | Diwakili J1 | Diwakili J1 | J1, dicolok langsung | 24 x 15,6 mm terukur; header 4 pin di tengah sisi pendek; modul menggantung ke luar ke arah area LCD | DS-HX1
MOD-LCD | LCD karakter 16 x 2 | HS1602A (Shenzhen Hansheng Industrial Co., Ltd.), pengontrol SPLC780 | Diwakili J2 | Di luar PCB (dibaut ke tutup) | J2 lewat kabel F-M | Catu 5 V (diputuskan 15 Okt. 2026) | DS-LCD1
MOD-I2C | Backpack I2C LCD | PCF8574T (NXP), alamat 0x27 | Tidak dipakai | Tidak dipakai (menempel di LCD) | J2 | Pull-up SDA/SCL ke VCC: 4,93 V terukur | DS-I2C1
MOD-LLS | Level shifter 4 kanal | Modul penggeser level dua arah 4 kanal, MOSFET BSS138 (generik) | Diwakili J3 dan J4 | Diwakili J3 dan J4 | J3 (LV) dan J4 (HV) | Dibeli, belum tiba; ±13,3 x 16 mm; kanal 1-2 untuk SDA/SCL | DS-LLS1
MOD-LC | Load cell 80 kg | CZL601 (Eagle Weigh, seri CZL 601) / CZL-601 (GJ Impex); kapasitas 80 kg | Tidak dipakai | Tidak dipakai (di luar PCB) | Terminal modul HX711 | Warna kabel: eksitasi = hitam dan putih, sinyal = merah dan hijau (hasil ukur, beda dari datasheet) | DS-LC1
Bagian di luar PCB, tercatat di sini supaya nama resminya tetap satu tempat.

Sheet: Asumsi dan sisa
No | Asumsi / sisa | Catatan
1 | Jarak baris header level shifter 10,16 mm | Perkiraan: lebar modul 13,3 mm hanya cocok dengan 10,16. Ukur saat modul tiba sebelum jalur dibuat
2 | Header HX711 1,5 mm dari tepi modul | Perkiraan; ukur
3 | Penempatan v2 dari tangkapan layar Fusion | Toleransi sekitar 1 mm; lihat pcb/desain-pcb-hgd.md Bagian 8.4 dan pcb/gambar/penempatan-pcb-hgd.svg
4 | Zona antena 15 mm di samping dan depan antena | Dari ringkasan pedoman Espressif (NextPCB); belum dicocokkan dengan dokumen Espressif
5 | Edge.Cuts dan lubang M3 belum ditentukan | Setelah sisi atas selesai; satu M3 dekat SW1
6 | Tanpa baterai; catu USB saja | Tidak ada catu luar ke VIN bersamaan dengan USB
7 | Tidak ada proteksi polaritas, sekering, atau pelindung ESD | Cukup untuk perangkat berdaya USB
8 | Pemberian jalur belum dilakukan | Usul: dua lapis, GND pour, sinyal 0,3 mm, rail 0,5 mm, jarak minimum 0,25 mm; sesuaikan dengan aturan kelas dan pabrik
9 | Soket tidak berkunci | Shifter terbalik 180° memberi 5 V ke sisi LV dan GPIO: tandai pin 1 dan HV/LV di B.Silkscreen
