raden-ayu44/embedded-systems-finpro/pengukuran/tabel-pengukuran-hgd.xlsx

Sheet: Petunjuk
Tabel pengukuran jangka sorong (hand grip dynamometer)
Satu tab per komponen. Dipakai bersama oleh housing grip, housing elektronik, dan layout PCB.
Legenda: sel BIRU dengan latar KUNING = isi hasil ukur (Ukur 1 sampai 3). Rata-rata, sebaran, dan status dihitung otomatis. Status hanya muncul bila "Acuan resmi (angka)" terisi.
Cara mengukur: jangka sorong digital (resolusi umumnya 0,01 mm); tutup rahang dan nol-kan sebelum mulai; ukur 3 kali, catat rata-rata dan sebaran.
Rahang: L = rahang luar (dimensi luar), D = rahang dalam (diameter lubang, lebar celah), K = batang kedalaman (kedalaman, tinggi dari permukaan).
Jarak pusat-ke-pusat dua lubang berdiameter sama = jarak sisi dalam ke sisi dalam + diameter, atau jarak sisi luar ke sisi luar - diameter. Pitch pin atau header: ukur 10 pitch lalu bagi 10.
Jangan menekan keras komponen elektronik; ukur dalam keadaan lepas dari daya.
Nilai CAD = hasil ukur + kelonggaran 0,2-0,3 mm per sisi (lubang M3 dimodelkan 3,4 mm). Footprint PCB memakai ukuran terukur dengan toleransi sesuai pabrik PCB.
Kolom "Angka resmi" hanya memuat angka dari datasheet atau standar yang disebut di kolom sumber; nomor dalam kurung siku ([4], [6], dan seterusnya) mengikuti daftar pustaka di datasheet/datasheet-library.md. Bila tertulis "belum resmi" atau "umum", angka itu hanya acuan umum sampai datasheetnya diambil. Selalu ukur komponen yang benar-benar dipegang.
Tag di kolom "Dipakai untuk": [PCB] footprint atau layout PCB, [Housing] cutout atau ruang housing elektronik, [Grip] housing grip dan load cell, [Cetak] pengecekan hasil cetak.
Nilai resistansi resistor tidak bisa diukur dengan jangka sorong; gunakan multimeter atau kode warna. Baris C9 (resistansi load cell) memakai multimeter, satuan ohm.
Terisi per 10-12 Okt. 2026: ESP32 (E1-E8, E10), load cell (C1, C5, C7, C9). Sisanya masih kosong.
Tab | Komponen | Nama part resmi | Datasheet atau dokumen | Jumlah baris
ESP32 | ESP32 DevKit V1 (30 pin) | Papan: DOIT ESP32 DevKit V1; modul di papan: ESP32-WROOM-32D (Espressif) | DS-ESP1 [7] (datasheet/pdf/ESP32-WROOM-32D_32U_datasheet.pdf); DS-ESP2 [9]; datasheet/datasheet-library.md | 21
LED | LED 5 mm diffused | Belum ada nomor part (LED generik, kemasan 5 mm) | DS-LED1 belum diambil | 6
Resistor | Resistor pembatas LED, axial | Belum ada nomor part (resistor 100 ohm, 1/4 W, generik) | DS-RES1 (opsional) | 5
Tombol | Tactile push button | Belum ada nomor part (tactile 6 x 6 mm, THT, generik) | DS-BTN1 belum diambil | 5
HX711 | Modul HX711 | Modul XFW-HX711 dengan chip HX711 (Avia Semiconductor) | DS-HX1 [1] listing, [2] Avia (datasheet/pdf/HX711_datasheet_Avia.pdf), [3] | 5
LCD I2C | LCD 1602 dengan backpack I2C | LCD: HS1602A (Shenzhen Hansheng Industrial); backpack: PCF8574 atau PCF8574A (NXP), penandaan chip belum diperiksa | DS-LCD1 [11], [12] (datasheet/pdf/HS1602A_datasheet.pdf); DS-I2C1 [13] | 6
Load cell | Load cell 80 kg | CZL601 (Eagle Weigh) / CZL-601 (GJ Impex), kapasitas 80 kg | DS-LC1 [4] listing, [5] Eagle Weigh, [6] GJ Impex (datasheet/pdf/GJ_Impex_CZL-601_load_cell.pdf, CZL601_Datasheet.pdf) | 9
Baut dan mur | Baut, washer, dan mur | ISO 4017 M6 x 25 kelas 8.8; washer ISO 7089 M6; mur ISO 4032 M6 (bagian modul cetak); M3 untuk bagian modul 3D printing | DS-MAT3 (ISO 898-1 dan standar dimensi) belum diambil | 3
Kabel dan konektor | Kabel USB dan konektor jumper | Kabel micro-USB (USB 2.0 Micro-B); konektor jumper Dupont 2,54 mm | Tidak ada datasheet; cangkang plug bervariasi per produsen | 2
Hasil cetak | Part hasil cetak 3D | Bukan komponen beli; spacer PLA dan klem kabel | housing-load-cell/desain-housing-load-cell.md; housing-load-cell/fusion/ | 1
Pelat logam | Pelat logam batang A dan B | Aluminium 6061-T6, 170 x 30 x 10 mm (pesanan) | DS-MAT1 belum diambil; housing-load-cell/asumsi.md | 1

Sheet: ESP32
Pengukuran: ESP32 DevKit V1 (30 pin)
Nama part resmi | Papan: DOIT ESP32 DevKit V1; modul di papan: ESP32-WROOM-32D (Espressif)
Datasheet / dokumen | DS-ESP1 [7] (datasheet/pdf/ESP32-WROOM-32D_32U_datasheet.pdf); DS-ESP2 [9]; datasheet/datasheet-library.md
Tab ini menampung baris pengukuran komponen di atas. Lihat tab Petunjuk untuk cara mengukur dan legenda.
ID | Dimensi yang diukur | Rahang | Dipakai untuk | Nominal / catatan lama | Angka resmi (teks) | Sumber angka resmi | Acuan resmi (angka) | Toleransi +- | Ukur 1 | Ukur 2 | Ukur 3 | Rata-rata | Sebaran | Status terhadap acuan | Tanggal ukur | Catatan hasil
E1 | Panjang papan PCB (tanpa pin) | L | [Housing] outline dan ruang | Bervariasi antar merek; ukur | Tidak ada gambar dimensi pabrikan untuk papan V1 | DS-ESP2 (S3 [9] tanpa dimensi) |  |  | 51.50 |  |  | 51.500 |  |  | 10 Okt. 2026 | 51,5 (10 Okt. 2026)
E2 | Lebar papan PCB | L | [Housing] outline dan ruang | Idem | Tidak ada gambar dimensi pabrikan untuk papan V1 | DS-ESP2 (S3 [9] tanpa dimensi) |  |  | 28.20 |  |  | 28.200 |  |  | 10 Okt. 2026 | 28,2
E3 | Tebal PCB saja | L | [Housing] slot atau penahan | - |  |  |  |  | 1.00 |  |  | 1.000 |  |  | 10 Okt. 2026 | 1,0
E4 | Tinggi total (PCB + modul WROOM + konektor USB, tanpa pin bawah) | L atau K | [Housing] kedalaman ruang di bawah lid | - |  |  |  |  | 4.20 |  |  | 4.200 |  |  | 10 Okt. 2026 | 4,2 (PCB + modul WROOM). Dengan pin: total 12,4; papan + pin 9,2; papan + plastik header 3,4; 6,6 di atas bibir soket
E5 | Jarak antar dua baris header (pusat ke pusat) | L atau D | [PCB] footprint header atau socket | Biasanya kelipatan 2,54 mm; ukur | Header 2,54 mm (0,1 in) standar; belum ada angka resmi papan | DS-ESP2 |  |  | 25.30 |  |  | 25.300 |  |  | 10 Okt. 2026 | 25,3 (pakai 25,4 untuk soket)
E6 | Pitch pin header (10 pitch dibagi 10) | L | [PCB] footprint | 2,54 mm (umum) | 2,54 mm (standar) | DS-ESP2 |  |  | 2.54 |  |  | 2.540 |  |  | 10 Okt. 2026 | 2,54 (15 pin per baris)
E7 | Diameter dan panjang pin header | L | [PCB] diameter lubang | - |  |  |  |  | 0.50 |  |  | 0.500 |  |  | 10 Okt. 2026 | Diameter 0,5; ekor pin di bawah plastik 5,8
E8 | Lebar x tinggi cangkang konektor USB | L | [Housing] cutout USB | - |  |  |  |  |  |  |  |  |  |  | 10 Okt. 2026 | 2,7 x 5,7 x 7,7 (urutan seperti dicatat; lihat `esp32_dimensi_acuan.xlsx`)
E9 | Posisi sumbu konektor USB dari tepi papan dan dari permukaan PCB | L atau K | [Housing] posisi cutout | - |  |  |  |  |  |  |  |  |  |  |  | Belum diukur
E10 | Panjang konektor USB yang menonjol dari tepi papan | K | [Housing] kedalaman cutout | - |  |  |  |  | 0.00 |  |  | 0.000 |  |  | 10 Okt. 2026 | 0 (konektor tidak menonjol keluar tepi papan)
E11 | Lubang mounting papan (jika ada): diameter dan jarak antar lubang | D | [PCB] [Housing] tiang mounting | Banyak DevKit tidak punya; jika tidak ada, pakai socket |  |  |  |  |  |  |  |  |  |  |  | Belum diukur
EM1 | Modul WROOM-32D: lebar | L | [PCB] [Housing] footprint modul |  | 18,00 mm | [7] Gambar 8 (DS-ESP1) | 18.00 | 0.15
EM2 | Modul WROOM-32D: panjang | L | [PCB] [Housing] footprint modul |  | 25,50 mm | [7] Gambar 8 (DS-ESP1) | 25.50 | 0.15
EM3 | Modul WROOM-32D: tebal total | L | [Housing] tinggi |  | 3,10 mm | [7] gambar sisi (DS-ESP1) | 3.10 | 0.15 | 3.20 |  |  | 3.200 |  | DALAM TOLERANSI | 10 Okt. 2026 | Hitungan: tebal papan + modul 4,2 mm dikurangi tebal PCB papan 1,0 mm (E3, E4); dalam toleransi datasheet (maks 3,25 mm).
EM4 | Area antena PCB: lebar x panjang | - | [PCB] area bebas tembaga |  | 18 x 6,19 mm | [7] Gambar 8 dan 11 (DS-ESP1)
EM5 | Pelindung logam: lebar x panjang | - | [Housing] |  | 15,8 x 17,6 mm | [7] Gambar 8 (DS-ESP1)
EM6 | Pad ground tengah (sisi) | - | [PCB] |  | 3,6 mm | [7] Gambar 8 (DS-ESP1)
EM7 | Jumlah pad dan pitch | - | [PCB] |  | 38 pad, pitch 1,27 mm | [7] Gambar 11 (DS-ESP1)
EM8 | Ukuran pad (pola PCB) | - | [PCB] |  | 1,50 x 0,90 mm | [7] Gambar 11 (DS-ESP1)
EM9 | Rentang pin 1-14 (pusat ke pusat) | - | [PCB] |  | 16,51 mm (= 13 x 1,27) | [7] Gambar 11 (DS-ESP1) | 16.51
EM10 | Rentang pin 15-24 (pusat ke pusat) | - | [PCB] |  | 11,43 mm (= 9 x 1,27) | [7] Gambar 11 (DS-ESP1) | 11.43

Sheet: LED
Pengukuran: LED 5 mm diffused
Nama part resmi | Belum ada nomor part (LED generik, kemasan 5 mm)
Datasheet / dokumen | DS-LED1 belum diambil
Tab ini menampung baris pengukuran komponen di atas. Lihat tab Petunjuk untuk cara mengukur dan legenda.
ID | Dimensi yang diukur | Rahang | Dipakai untuk | Nominal / catatan lama | Angka resmi (teks) | Sumber angka resmi | Acuan resmi (angka) | Toleransi +- | Ukur 1 | Ukur 2 | Ukur 3 | Rata-rata | Sebaran | Status terhadap acuan | Tanggal ukur | Catatan hasil
L1 | Diameter badan | L | [Housing] lubang di lid (tambah 0,2-0,3 mm per sisi) | 5 mm (label) | 5 mm (kemasan T-1 3/4, umum; belum resmi) | DS-LED1 belum ada
L2 | Diameter flensa (rim) di dasar | L | [Housing] dudukan atau counterbore | Sedikit di atas 5 mm; ukur
L3 | Tinggi dari dasar flensa ke puncak | K | [Housing] kedalaman dan tonjolan | -
L4 | Diameter kaki | L | [PCB] diameter lubang | -
L5 | Jarak antar kaki (pusat ke pusat) di pangkal | L | [PCB] footprint | 2,54 mm (umum)
L6 | Panjang kaki (anoda dan katoda) | L atau K | [PCB] pembentukan kaki | Anoda lebih panjang

Sheet: Resistor
Pengukuran: Resistor pembatas LED, axial
Nama part resmi | Belum ada nomor part (resistor 100 ohm, 1/4 W, generik)
Datasheet / dokumen | DS-RES1 (opsional)
Tab ini menampung baris pengukuran komponen di atas. Lihat tab Petunjuk untuk cara mengukur dan legenda.
ID | Dimensi yang diukur | Rahang | Dipakai untuk | Nominal / catatan lama | Angka resmi (teks) | Sumber angka resmi | Acuan resmi (angka) | Toleransi +- | Ukur 1 | Ukur 2 | Ukur 3 | Rata-rata | Sebaran | Status terhadap acuan | Tanggal ukur | Catatan hasil
R1 | Panjang badan | L | [PCB] footprint | - | Badan 6,3 x 2,5 mm (DIN 0207, umum; belum resmi) | DS-RES1 opsional
R2 | Diameter badan | L | [PCB] jarak antar komponen | -
R3 | Diameter kaki | L | [PCB] diameter lubang | -
R4 | Panjang kaki dari badan | L | [PCB] pembentukan kaki | -
R5 | Jarak antar lubang saat dipasang horizontal (pusat ke pusat) | L atau D | [PCB] footprint | Umum 7,62 atau 10,16 mm, bergantung cara menekuk

Sheet: Tombol
Pengukuran: Tactile push button
Nama part resmi | Belum ada nomor part (tactile 6 x 6 mm, THT, generik)
Datasheet / dokumen | DS-BTN1 belum diambil
Tab ini menampung baris pengukuran komponen di atas. Lihat tab Petunjuk untuk cara mengukur dan legenda.
ID | Dimensi yang diukur | Rahang | Dipakai untuk | Nominal / catatan lama | Angka resmi (teks) | Sumber angka resmi | Acuan resmi (angka) | Toleransi +- | Ukur 1 | Ukur 2 | Ukur 3 | Rata-rata | Sebaran | Status terhadap acuan | Tanggal ukur | Catatan hasil
B1 | Panjang dan lebar badan | L | [PCB] footprint | 6 x 5 mm (BOM) atau 6 x 6 mm (catatan lama); ukur | 6 x 6 mm (catatan lama) atau 6 x 5 mm (BOM); belum resmi | DS-BTN1 belum ada
B2 | Tinggi badan tanpa tombol | L atau K | [PCB] ketinggian di atas board | -
B3 | Tinggi total termasuk tombol | K | [Housing] panjang tombol atau cutout di lid | -
B4 | Diameter tombol (actuator) | L | [Housing] lubang di lid | -
B5 | Jarak antar pin (pusat ke pusat) dan diameter pin | L | [PCB] footprint | -

Sheet: HX711
Pengukuran: Modul HX711
Nama part resmi | Modul XFW-HX711 dengan chip HX711 (Avia Semiconductor)
Datasheet / dokumen | DS-HX1 [1] listing, [2] Avia (datasheet/pdf/HX711_datasheet_Avia.pdf), [3]
Tab ini menampung baris pengukuran komponen di atas. Lihat tab Petunjuk untuk cara mengukur dan legenda.
ID | Dimensi yang diukur | Rahang | Dipakai untuk | Nominal / catatan lama | Angka resmi (teks) | Sumber angka resmi | Acuan resmi (angka) | Toleransi +- | Ukur 1 | Ukur 2 | Ukur 3 | Rata-rata | Sebaran | Status terhadap acuan | Tanggal ukur | Catatan hasil
H1 | Panjang x lebar PCB | L | [Housing] ruang | - | 24 x 16 mm (foto listing, bukan angka pabrikan) | DS-HX1 S1 [1]
H2 | Tebal PCB dan tinggi total (chip, terminal) | L atau K | [Housing] kedalaman ruang | -
H3 | Diameter dan jarak antar lubang mounting | D | [Housing] tiang mounting | -
H4 | Pitch dan posisi header (VCC, DT, SCK, GND) dari tepi | L | [PCB] footprint header | 2,54 mm (umum) | Pitch 2,54 mm (umum) | DS-HX1
H5 | Posisi terminal load cell (E+, E-, A-, A+) dari tepi | L | [Housing] rute kabel | -

Sheet: LCD I2C
Pengukuran: LCD 1602 dengan backpack I2C
Nama part resmi | LCD: HS1602A (Shenzhen Hansheng Industrial); backpack: PCF8574 atau PCF8574A (NXP), penandaan chip belum diperiksa
Datasheet / dokumen | DS-LCD1 [11], [12] (datasheet/pdf/HS1602A_datasheet.pdf); DS-I2C1 [13]
Tab ini menampung baris pengukuran komponen di atas. Lihat tab Petunjuk untuk cara mengukur dan legenda.
ID | Dimensi yang diukur | Rahang | Dipakai untuk | Nominal / catatan lama | Angka resmi (teks) | Sumber angka resmi | Acuan resmi (angka) | Toleransi +- | Ukur 1 | Ukur 2 | Ukur 3 | Rata-rata | Sebaran | Status terhadap acuan | Tanggal ukur | Catatan hasil
D1 | Panjang x lebar PCB LCD | L | [Housing] outline dan cutout lid | Umumnya sekitar 80 x 36 mm; ukur | 80,0 +-0,3 x 36,0 +-0,3 mm | [12] HS1602A, DS-LCD1; vendor 80 x 36 [11]
D2 | Tebal total modul (LCD + backpack) | L | [Housing] kedalaman | - | 11,0 mm (maks 12,0 atau 9,0); vendor 15 mm | [12] HS1602A; [11] vendor
D3 | Area tampilan (jendela): panjang x lebar dan offset dari tepi PCB | L | [Housing] cutout jendela di lid | - | Visible area 64,5 x 13,9 mm (gambar 13,8); vendor 64,5 x 16 mm | [12] HS1602A; [11] vendor
D4 | Diameter dan jarak antar lubang mounting | D | [Housing] tiang mounting | Umumnya sekitar 75 x 31 mm; ukur | 4 x diameter 2,5 mm, jarak 75,0 x 31,0 mm | [12] HS1602A
D5 | Tinggi backpack I2C di belakang PCB | K | [Housing] clearance | -
D6 | Posisi dan pitch header 4 pin (GND, VCC, SDA, SCL) dari tepi | L | [PCB] footprint | 2,54 mm (umum) | 16 pin 2,54 mm pada modul LCD; header 4 pin backpack tanpa angka resmi | [12] HS1602A

Sheet: Load cell
Pengukuran: Load cell 80 kg
Nama part resmi | CZL601 (Eagle Weigh) / CZL-601 (GJ Impex), kapasitas 80 kg
Datasheet / dokumen | DS-LC1 [4] listing, [5] Eagle Weigh, [6] GJ Impex (datasheet/pdf/GJ_Impex_CZL-601_load_cell.pdf, CZL601_Datasheet.pdf)
Tab ini menampung baris pengukuran komponen di atas. Lihat tab Petunjuk untuk cara mengukur dan legenda.
ID | Dimensi yang diukur | Rahang | Dipakai untuk | Nominal / catatan lama | Angka resmi (teks) | Sumber angka resmi | Acuan resmi (angka) | Toleransi +- | Ukur 1 | Ukur 2 | Ukur 3 | Rata-rata | Sebaran | Status terhadap acuan | Tanggal ukur | Catatan hasil
C1 | Panjang x lebar x tinggi | L | [Grip] verifikasi spesifikasi | 130 x 28 x 22 mm (gambar penjual; GJ Impex menulis lebar 30 mm) | 130 x 30 x 22 mm (GJ Impex); 130 x 28 x 22 mm (vendor) | [6] GJ Impex; [4] vendor |  |  |  |  |  |  |  |  | 10 Okt. 2026 | 130 x 28 x 21,5 (10 Okt. 2026)
C2 | Diameter lubang baut di ujung tetap dan ujung bebas (KRITIS) | D | [Grip] lubang baut di pelat dan spacer A dan B | Ulir M6 (gambar penjual) | Ulir M6 (vendor) | [4]
C3 | Jarak pusat-ke-pusat antar lubang di tiap ujung (KRITIS) | L atau D | [Grip] pola lubang | 106 mm antar pasangan, 15 mm melintang (gambar penjual) | 106 mm antar pasangan, 15 mm melintang (gambar penjual) | [4]
C4 | Jarak pusat lubang dari ujung badan | K atau L | [Grip] posisi dan panjang spacer | 12 mm (gambar penjual) | 12 mm (gambar penjual) | [4]
C5 | Arah panah beban dan sisi (22 atau 28 mm) yang searah panah (KRITIS; catat, bukan ukur) | - | [Grip] sisi yang menghadap telapak, tebal total grip | - |  |  |  |  |  |  |  |  |  |  | 12 Okt. 2026 | Stiker panah di muka ujung bebas, sepanjang tebal 21,5 mm, menunjuk ke arah B (A di atas), sesuai stiker asli (diperbarui 12 Okt. 2026; sebelumnya tertulis "ke bawah, searah lubang pasang"). Gaya nyata B ke A berlawanan: pembacaan negatif, tanda diatur di firmware
C6 | Lubang tembus atau buta, polos atau berulir; kedalaman | K atau D | [Grip] jenis dan panjang baut | -
C7 | Posisi keluar kabel dan diameter kabel | L | [Grip] jepit kabel dan jangkauan housing elektronik | Panjang kabel sekitar 28 cm (listing) atau 0,42 m (GJ Impex), ukur dengan meteran; diameter 4 mm (GJ Impex) | Kabel diameter 4 mm, 0,42 m (GJ Impex); sekitar 28 cm (vendor) | [6]; [4] |  |  |  |  |  |  |  |  | 11 Okt. 2026 | Diameter 4 mm (11 Okt. 2026). Kabel keluar dari muka samping panjang, tengah tinggi, lewat lubang Ø5 mm dengan pusat 4,2 mm dari ujung (tepi ke arah tengah 6,7 mm). Panjang belum diukur. 4 kabel: merah, hitam, putih, hijau
C8 | Slot atau lubang di tengah badan (diameter, posisi), jika ada | D | [Grip] petunjuk tipe elemen dan kepekaan titik tekan | -
C9 | Resistansi antar pasangan kabel (multimeter, rentang 2k; satuan ohm, bukan mm) | - | [Grip] [PCB] pemetaan eksitasi dan sinyal | Datasheet: masukan 401 +-10 ohm, keluaran 350 +-5 ohm | Masukan 400 +-10 ohm (GJ Impex), 401 +-10 (vendor); keluaran 350 +-5 ohm (keduanya) | [6]; [4] |  |  |  |  |  |  |  |  | 10 Okt. 2026 | Hitam-putih 393; merah-hijau 347; pasangan silang 260-306 (dua kali pengukuran, konsisten)

Sheet: Baut dan mur
Pengukuran: Baut, washer, dan mur
Nama part resmi | ISO 4017 M6 x 25 kelas 8.8; washer ISO 7089 M6; mur ISO 4032 M6 (bagian modul cetak); M3 untuk bagian modul 3D printing
Datasheet / dokumen | DS-MAT3 (ISO 898-1 dan standar dimensi) belum diambil
Tab ini menampung baris pengukuran komponen di atas. Lihat tab Petunjuk untuk cara mengukur dan legenda.
ID | Dimensi yang diukur | Rahang | Dipakai untuk | Nominal / catatan lama | Angka resmi (teks) | Sumber angka resmi | Acuan resmi (angka) | Toleransi +- | Ukur 1 | Ukur 2 | Ukur 3 | Rata-rata | Sebaran | Status terhadap acuan | Tanggal ukur | Catatan hasil
F1 | Diameter ulir dan panjang di bawah kepala | L | [Grip] [Cetak] lubang dan panjang baut | Grip: M6 x 25 (washer logam). M3 x 10 mm untuk bagian modul 3D printing | M6 x 25, kepala heksagonal (ISO 4017) | ISO 4017
F2 | Diameter kepala dan tinggi kepala | L atau K | [Grip] tonjolan di luar pelat (tanpa counterbore) | - | Kepala M6: lebar antar sisi 10 mm, tinggi 4,0 mm (ISO 4017); washer M6: d1 6,4, d2 12, tebal 1,6 mm (ISO 7089) | ISO 4017; ISO 7089
F3 | Lebar antar sisi (across flats) dan tebal | L | [Cetak] kantong heksagonal (bagian modul; grip memakai ulir load cell, tanpa mur) | - | Mur M6: lebar antar sisi 10 mm, tebal maks 5,2 mm (ISO 4032) | ISO 4032

Sheet: Kabel dan konektor
Pengukuran: Kabel USB dan konektor jumper
Nama part resmi | Kabel micro-USB (USB 2.0 Micro-B); konektor jumper Dupont 2,54 mm
Datasheet / dokumen | Tidak ada datasheet; cangkang plug bervariasi per produsen
Tab ini menampung baris pengukuran komponen di atas. Lihat tab Petunjuk untuk cara mengukur dan legenda.
ID | Dimensi yang diukur | Rahang | Dipakai untuk | Nominal / catatan lama | Angka resmi (teks) | Sumber angka resmi | Acuan resmi (angka) | Toleransi +- | Ukur 1 | Ukur 2 | Ukur 3 | Rata-rata | Sebaran | Status terhadap acuan | Tanggal ukur | Catatan hasil
F4 | Lebar x tinggi cangkang plug dan panjang plug | L | [Housing] cutout USB | -
F5 | Lebar x tinggi housing konektor | L | [Housing] ruang dan rute kabel | -

Sheet: Hasil cetak
Pengukuran: Part hasil cetak 3D
Nama part resmi | Bukan komponen beli; spacer PLA dan klem kabel
Datasheet / dokumen | housing-load-cell/desain-housing-load-cell.md; housing-load-cell/fusion/
Tab ini menampung baris pengukuran komponen di atas. Lihat tab Petunjuk untuk cara mengukur dan legenda.
ID | Dimensi yang diukur | Rahang | Dipakai untuk | Nominal / catatan lama | Angka resmi (teks) | Sumber angka resmi | Acuan resmi (angka) | Toleransi +- | Ukur 1 | Ukur 2 | Ukur 3 | Rata-rata | Sebaran | Status terhadap acuan | Tanggal ukur | Catatan hasil
P1 | Diameter lubang, lebar slot, dan tebal dinding hasil cetak dibanding nilai CAD | D atau L | [Cetak] tabel dimensi CAD vs hasil ukur untuk laporan modul; koreksi kelonggaran | -

Sheet: Pelat logam
Pengukuran: Pelat logam batang A dan B
Nama part resmi | Aluminium 6061-T6, 170 x 30 x 10 mm (pesanan)
Datasheet / dokumen | DS-MAT1 belum diambil; housing-load-cell/asumsi.md
Tab ini menampung baris pengukuran komponen di atas. Lihat tab Petunjuk untuk cara mengukur dan legenda.
ID | Dimensi yang diukur | Rahang | Dipakai untuk | Nominal / catatan lama | Angka resmi (teks) | Sumber angka resmi | Acuan resmi (angka) | Toleransi +- | Ukur 1 | Ukur 2 | Ukur 3 | Rata-rata | Sebaran | Status terhadap acuan | Tanggal ukur | Catatan hasil
P2 | Tebal, lebar, panjang, kerataan di 3 titik | L | [Grip] cek terhadap parameter `bar_t`, lebar 30 mm, panjang 170 mm | Sesuai pesanan; ukur | Al 6061-T6; 170 x 30 x 10 mm (pesanan) | housing-load-cell/asumsi.md
