raden-ayu44/embedded-systems-finpro/housing-elektronik/fusion/electronics_housing_lipped.step

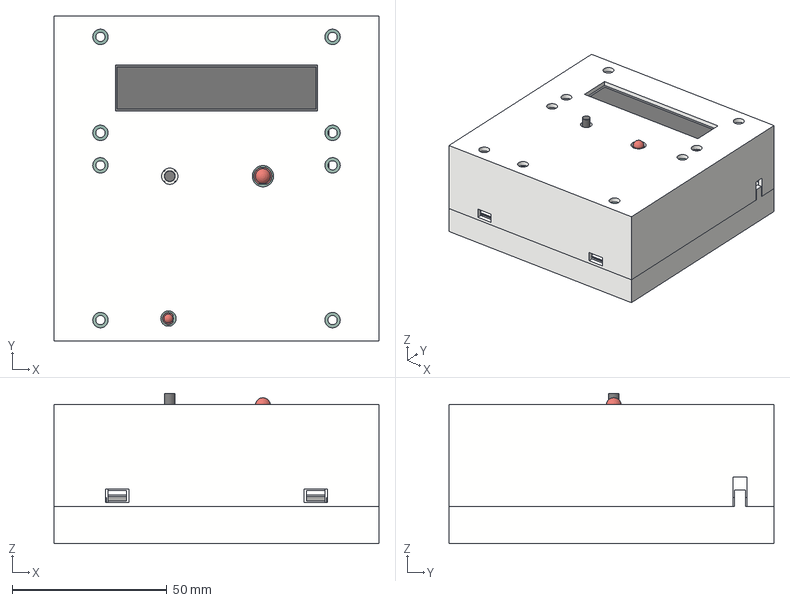
[picture p5: CAD file, 2026-10-30]
housing-elektronik/fusion/electronics_housing_lipped.step
105.0 x 105.0 x 48.6 mm
