raden-ayu44/embedded-systems-finpro/kalibrasi/dimensi_dumbbell.xlsx

Ukuran (kg) | A diameter gagang (mm) | B panjang gagang (mm) | C panjang total (mm) | D tinggi sisi datar ke sisi datar (mm) | E tinggi sudut ke sudut (mm) | Dipakai untuk kalibrasi
1 | 27 | 130 | 227 | 59 | 68 | ya
2 | 27 | 130 | 240 | 68 | 79 | ya
3 | 27 | 130 | 246 | 75 | 87 | ya
4 | 27 | 130 | 269 | 88 | 102 | ya
5 | 32 | 130 | 289 | 95 | 110 | ya
6 | 32 | 130 | 300 | 102 | 118 | ya
7 | 32 | 130 | 300 | 102 | 118
8 | 32 | 130 | 304 | 106 | 122
9 | 32 | 130 | 314 | 108 | 125
10 | 32 | 130 | 320 | 118 | 136
12.5 | 32 | 130 | 330 | 126 | 145
15 | 32 | 130 | 336 | 134 | 155
17.5 | 32 | 130 | 348 | 142 | 164
20 | 32 | 130 | 360 | 148 | 171
22.5 | 32 | 130 | 365 | 148 | 171
25 | 32 | 130 | 380 | 156 | 180
27.5 | 32 | 130 | 382 | 160 | 185
30 | 32 | 130 | 392 | 164 | 189
32.5 | 32 | 130 | 395 | 172 | 199
35 | 32 | 130 | 400 | 180 | 208
37.5 | 32 | 130 | 412 | 182 | 210
40 | 32 | 130 | 425 | 183 | 211
42.5 | 32 | 130 | 425 | 183 | 211
45 | 32 | 130 | 432 | 193 | 223
Sumber: tabel 'Hex Dumbbell Dimensions' (umum, bukan hasil ukur sendiri). Toleransi ±2 mm. Ukur dumbbell sendiri bila perlu.
Tumpukan 20 kg (6 kg + 4 kg), tinggi ~ D6 + D4 (mm)
