raden-ayu44/embedded-systems-finpro/kalibrasi/hgd_perhitungan.xlsx

Sheet: Mekanik
Perhitungan mekanik: kekakuan pelat, tegangan, celah, spacer, baut, dan massa (housing grip)
Legenda: sel BIRU dengan latar KUNING = input yang boleh diubah; HIJAU = tautan ke blok Elektrik; HITAM = rumus. Model: kantilever, spacer dan baut dianggap kaku; lenturan load cell, tinggi penutup, dan margin rakit ada di anggaran celah. Ini hitungan kasar untuk arah desain, bukan verifikasi.
1. Input geometri dan bahan
Besaran | Nilai | Satuan | Rumus / arti / catatan | Referensi
Beban rancangan (genggam maksimum) | 70.0 | kgf | Tautan ke Input Elektrik (beban maksimum yang dipakai) | Blok Elektrik, Input
Percepatan gravitasi | 9.80665 | m/s^2 | Tautan ke Input Elektrik | Konstanta standar
Lebar pelat A dan B (b) | 30.0 | mm | Pelat aluminium polos | housing-load-cell/asumsi.md Bagian 2
Tebal pelat (h) | 10.0 | mm | Al 6061-T6 (nilai keputusan) | asumsi.md Bagian 2; HL9
Panjang pelat | 170.0 | mm | Dipotong dari pelat 170 x 30 x 10 | asumsi.md Bagian 2
Modulus elastisitas aluminium (E) | 70000 | MPa | 70 GPa dipakai di seluruh perhitungan; belum ada datasheet pemasok | DS-MAT1 (belum diambil); asumsi.md Bagian 2
Kuat luluh minimum Al 6061-T6 | 240 | MPa | Nilai minimum yang dipakai untuk faktor keamanan | asumsi.md Bagian 2; DS-MAT1 (belum diambil)
Massa jenis aluminium | 2700 | kg/m^3 | Nilai umum Al 6061 | DS-MAT1 (belum diambil)
Panjang load cell | 130.0 | mm | Terukur 10 Okt. 2026 (gambar penjual 130) | tabel-pengukuran-hgd.xlsx tab Load cell (C1); DS-LC1
Tinggi load cell | 21.5 | mm | Terukur 10 Okt. 2026 (gambar penjual 22) | tabel-pengukuran-hgd.xlsx tab Load cell (C1); DS-LC1
Panjang blok ujung load cell (boss_L) | 28.0 | mm | Taksiran dari gambar penjual; ukur dengan jangka sorong | tabel-pengukuran-hgd.xlsx tab Load cell (C4); DS-LC1
Diameter lubang lewat di pelat | 6.6 | mm | Lubang lewat M6 seri sedang | ISO 273; asumsi.md Bagian 2.4
Celah pelat ke badan load cell | 2.5 | mm | Celah bebas-sentuh | asumsi.md Bagian 2.2
Tinggi ridge dan bidang tumpu | 5.0 | mm | Di sisi luar B | asumsi.md Bagian 3.3
2. Geometri turunan dan kekakuan pelat (kantilever)
Besaran | Nilai | Satuan | Rumus / arti / catatan | Referensi
Lengan tuas a | 37.0 | mm | a = L_lc/2 - boss_L | asumsi.md Bagian 2 (Model)
Jarak ujung jauh x | 102.0 | mm | x = L_lc - boss_L | asumsi.md Bagian 2 (Model)
Bentang bebas | 74.0 | mm | L_lc - 2 x boss_L | asumsi.md Bagian 2
Gaya rancangan F | 686.5 | N | F = kgf x g (kgf dianggap sama dengan kg-massa) | asumsi.md Bagian 2
Momen inersia penampang pelat I | 2500 | mm^4 | I = b h^3 / 12 | asumsi.md Bagian 2
Lenturan di titik beban, delta(a) | 0.066 | mm | delta(a) = F a^3 / (3 E I) | asumsi.md Bagian 2; HL9
Lenturan di ujung jauh, delta(x) | 0.241 | mm | delta(x) = F a^2 (3x - a) / (6 E I) | asumsi.md Bagian 2; HL9
Tegangan lentur di pangkal, sigma | 50.8 | MPa | sigma = F a (h/2) / I | asumsi.md Bagian 2
Tegangan bersih di lubang, sigma_net | 90.7 | MPa | sigma_net = sigma x b / (b - 2d); konservatif | asumsi.md Bagian 2
Faktor keamanan terhadap luluh | 2.6 | x | Kuat luluh / sigma_net | asumsi.md Bagian 2
3. Anggaran celah
Besaran | Nilai | Satuan | Rumus / arti / catatan | Referensi
Lenturan load cell sendiri pada beban rancangan | 0.5 | mm | Asumsi desain; belum diukur | asumsi.md Bagian 2.3
Tinggi penutup / area tengah di atas permukaan | 1.0 | mm | Asumsi desain | asumsi.md Bagian 2.3
Margin rakit (kerataan pelat, spacer, baut) | 0.3 | mm | Asumsi desain | asumsi.md Bagian 2.3
Total celah terpakai | 2.04 | mm | Lenturan ujung jauh + tiga butir di atas | asumsi.md Bagian 2.3
Sisa celah | 0.46 | mm | Harus positif | asumsi.md Bagian 2.3
Status celah | AMAN | -
4. Spacer PLA dan baut
Besaran | Nilai | Satuan | Rumus / arti / catatan | Referensi
Lebar spacer | 28.0 | mm | Selaras dengan lebar load cell terukur | asumsi.md Bagian 3.4
Panjang spacer | 28.0 | mm | Tidak boleh melewati blok ujung load cell | asumsi.md Bagian 3.4
Tebal spacer | 2.5 | mm | Sama dengan celah | asumsi.md Bagian 3.1
Diameter lubang di spacer (untuk luas bersih) | 6.5 | mm | Perhitungan asumsi.md memakai 6,5; lubang spacer keputusan 7,0 | asumsi.md Bagian 3.1, 2.4
Jumlah lubang per spacer | 2 | buah | Tiap spacer menutup dua lubang | asumsi.md Bagian 3.1
Modulus PLA | 3000 | MPa | Perkiraan ≈3 GPa; belum ada datasheet filamen | asumsi.md Bagian 3.1; DS-MAT2 (belum diambil)
Luas bersih spacer | 717.6 | mm^2 | Luas penuh dikurangi lubang | asumsi.md Bagian 3.1
Kompresi spacer | 0.0008 | mm | F t / (A E); dapat diabaikan terhadap celah | asumsi.md Bagian 3.1
Tekanan rata-rata spacer | 0.96 | MPa | F / A | asumsi.md Bagian 3.1
Momen pada spacer | 25399.2235 | N.mm | M = F a | asumsi.md Bagian 3.2
Modulus penampang spacer | 3658.666667 | mm^3 | S = b h^2 / 6 (penampang utuh) | asumsi.md Bagian 3.2
Tekanan tepi (metode lama, preload cukup) | 7.9 | MPa | M/S + tekanan rata-rata | asumsi.md Bagian 3.2
Diameter nominal ulir baut | 6.0 | mm | M6 | ISO 4017 / ISO 898-1
Torsi pengencang | 3.0 | N.m | Asumsi desain, di bawah batas baut kelas 8.8 | asumsi.md Bagian 3.2
Koefisien torsi K | 0.20 | - | Nilai umum baut kering | asumsi.md Bagian 3.2
Preload per baut | 2500 | N | T = K d F | asumsi.md Bagian 3.2
Jarak baut ke tepi dalam spacer | 16.0 | mm | Spacer 28 - 12 mm dari ujung | asumsi.md Bagian 3.2
Tarik baut per ujung (ungkit) | 1587.451469 | N | F a / l | asumsi.md Bagian 3.2
Gaya kontak di tepi dalam | 2273.916969 | N | F (a + l) / l | asumsi.md Bagian 3.2
Lebar kontak kerja (asumsi) | 5.0 | mm | Asumsi kerja | asumsi.md Bagian 3.2
Tekanan lokal di tepi dalam | 16.2 | MPa | Fc / (lebar x lebar kontak) | asumsi.md Bagian 3.2
Panjang baut | 25.0 | mm | M6 x 25, kelas 8.8 | ISO 4017
Tebal washer | 1.6 | mm | ISO 7089 untuk M6 | ISO 7089
Panjang ulir masuk | 10.9 | mm | Panjang baut - washer - pelat - spacer | asumsi.md Bagian 3.3
Ulir masuk dibanding diameter | 1.8 | x | Harus > 1 x d; ujung tidak menembus tinggi load cell | asumsi.md Bagian 3.3
Ujung baut dalam tinggi load cell | AMAN | - | Ulir tersedia sepanjang tinggi load cell (lubang tembus) | asumsi.md Bagian 3.3
5. Tebal total, massa, dan beban batas
Besaran | Nilai | Satuan | Rumus / arti / catatan | Referensi
Tebal total pelat dan load cell | 51.5 | mm | 10 + 2,5 + 21,5 + 2,5 + 10 + ridge | asumsi.md Bagian 3.3
Massa satu pelat | 0.138 | kg | Volume x massa jenis | asumsi.md
Massa sepasang pelat | 0.275 | kg | Dua pelat | asumsi.md
Selisih massa pelat B dengan input Elektrik (massa penekan sel) | -0.002 | kg | Mendekati nol berarti input Elektrik konsisten | Blok Elektrik, Input
Batas aman load cell | 96.0 | kgf | Kapasitas x overload aman | [6] GJ Impex (DS-LC1); dipilih konservatif
Batas destruktif load cell | 120.0 | kgf | Kapasitas x overload destruktif | [6] GJ Impex (DS-LC1); dipilih konservatif
Beban rancangan dibanding batas aman | 0.73 | x | < 1 berarti di bawah batas aman | Blok Elektrik, Hitung 7
Catatan: tidak ada stop overload mekanis; di atas sekitar 80 kgf remasan tidak terlindungi (asumsi.md Bagian 6). Angka overload 120%/150% adalah pilihan desain konservatif; vendor menyebut 150%/200%.

Sheet: Elektrik
Perhitungan elektrik: sinyal, ADC, noise, galat, dan kalibrasi (hand grip dynamometer, CZL 601 80 kg + HX711)
Input parameter - Hand grip dynamometer (CZL 601 80 kg + HX711)
Legenda: sel BIRU dengan latar KUNING = input yang boleh diubah. Blok Hitung, Galat, dan Kalibrasi di bawahnya berisi rumus dan ikut berubah. Sumber: DS-LC1 dan DS-HX1 di datasheet/datasheet-library.md ([4]-[6] load cell, [2] Avia).
Parameter | Nilai | Satuan | Sumber / catatan | Referensi (nomor di datasheet/datasheet-library.md)
Sensitivitas load cell (S) | 2 | mV/V | Eagle Weigh [5]: 2,0 +-0,15 mV/V; nominal | [5] Eagle Weigh (DS-LC1)
Kapasitas load cell | 80 | kg | Eagle Weigh [5] | [5] Eagle Weigh (DS-LC1)
Beban maksimum yang dipakai | 70 | kgf | Asumsi proyek: pria muda maks sekitar 59 kgf (Gotthelf) + margin | Gotthelf dkk. 2021 (sitasi/sitasi-hgd.md, kode G)
Beban genggam tipikal (untuk % galat) | 30 | kgf | Wanita 20-24 th rata-rata 31,7 kgf (Gotthelf) | Gotthelf dkk. 2021 (sitasi/sitasi-hgd.md, kode G)
Resistansi masukan jembatan | 400 | ohm | GJ Impex [6]: 400 +-10; vendor 401 +-10; ukur saat tiba | [6] GJ Impex; vendor [4] (DS-LC1)
Tegangan eksitasi E+ (V_exc) | 5 | V | Ukur di papan. Papan cacat: sekitar 4,3 V pada catu 5 V; catu 3,3 V: isi 3,3 | Ukur di papan; DS-HX1 Peringatan
AVDD HX711 | 5 | V | Ukur; harus sama dengan catu modul | [2] Avia (AVDD 2,6-5,5 V) (DS-HX1)
Gain kanal A | 128 | - | Avia [2]: 128 atau 64 | [2] Avia (DS-HX1)
Noise masukan 10 SPS | 50 | nV rms | Avia [2], gain 128 | [2] Avia (DS-HX1)
Noise masukan 80 SPS | 90 | nV rms | Avia [2], gain 128 | [2] Avia (DS-HX1)
Laju data terpilih | 10 | SPS | 10 (bawaan papan) atau 80 | [2] Avia (DS-HX1)
Lebar kode ADC | 24 | bit | Avia [2] | [2] Avia (DS-HX1)
Offset common-mode bawah | 1.2 | V | Avia: AGND + 1,2 V | [2] Avia (DS-HX1)
Offset common-mode atas | 1.3 | V | Avia: AVDD - 1,3 V | [2] Avia (DS-HX1)
Overload aman | 120 | % FS | GJ Impex [6] (konservatif; vendor 150) | [6] GJ Impex; vendor [4] (DS-LC1)
Overload destruktif | 150 | % FS | GJ Impex [6] (konservatif; vendor 200) | [6] GJ Impex; vendor [4] (DS-LC1)
Error gabungan | 0.03 | %RO | Eagle Weigh [5]: <= +-0,03 %RO | [5] Eagle Weigh (DS-LC1)
Creep (30 menit) | 0.025 | % FSO | GJ Impex [6]: <0,025 (vendor 0,0016 tidak dipakai) | [6] GJ Impex (DS-LC1)
Zero balance | 1 | % FS | GJ Impex [6]: <+-1 | [6] GJ Impex (DS-LC1)
Toleransi sensitivitas | 0.15 | mV/V | Eagle Weigh [5] | [5] Eagle Weigh (DS-LC1)
Efek suhu load cell (nol dan span) | 0.03 | % FSO/10 C | GJ Impex [6] | [6] GJ Impex (DS-LC1)
Perubahan suhu selama pemakaian | 10 | C | Asumsi | Asumsi
Drift offset HX711 | 6 | nV/C | Avia [2] | [2] Avia (DS-HX1)
Arus HX711 | 1.5 | mA | Avia [2]: < 1,5 mA | [2] Avia (DS-HX1)
Percepatan gravitasi | 9.80665 | m/s^2 | Konstanta standar | Konstanta standar (g_n = 9,80665 m/s^2)
Durasi tahan genggam | 4 | s | Asumsi protokol 3-5 s | Protokol V1 (sitasi/sitasi-hgd.md)
Massa bagian housing yang membebani sel | 0.14 | kg | Asumsi dari estimasi sebelumnya (0,14 kg untuk 90 derajat); ganti dengan timbangan | Asumsi; bandingkan dengan blok Mekanik
Sudut kemiringan antara tare dan pakai | 90 | derajat | Skenario terburuk 90 atau 180 | Asumsi
Jumlah pembacaan awal dibuang | 4 | sampel | Settling 400 ms pada 10 Hz | Asumsi
Perhitungan utama (semua rumus; ubah nilai di blok Input (baris 3 sampai 34))
Besaran | Nilai | Satuan | Rumus / arti | Referensi
1. Sinyal jembatan
Keluaran jembatan pada skala penuh | 10.000 | mV | S x V_exc | [5]; rumus ratiometrik jembatan
Keluaran pada beban maksimum | 8.750 | mV | S x V_exc x F/F_rated (kgf dianggap sama dengan kg) | [5]
Sensitivitas absolut | 125.000 | nV/g | Pengubah noise ke gram | [5]
2. Rentang ADC
Skala penuh ADC (+-) | 19.531 | mV | 0,5 x AVDD / gain | [2] Avia: skala penuh = 0,5 x AVDD / gain
Pemakaian rentang pada kapasitas penuh | 0.512 | - | Saturasi jika > 1 | [2]
Pemakaian rentang pada beban maksimum | 0.448 | - |  | [2]
Pemakaian pada overload aman | 0.614 | - |  | [2]
Pemakaian pada overload destruktif | 0.768 | - |  | [2]
Status saturasi | AMAN | - | Pada overload destruktif | [2]
3. Common-mode
Titik tengah jembatan | 2.500 | V | Perkiraan: E+/2 | [2] Avia: kisaran common-mode
Batas bawah | 1.200 | V | AGND + 1,2 | [2] Avia
Batas atas | 3.700 | V | AVDD - 1,3 | [2] Avia
Status | LULUS | - |  | [2]
4. Hitungan ADC (counts)
Hitungan pada kapasitas penuh | 4294967.296 | count | Pemakaian x 2^23 | [2] Avia: 24 bit
Faktor skala ideal | 53.687 | count/g | Bandingkan dengan hasil kalibrasi | [2]
LSB ideal | 18.626 | mg | Resolusi kuantisasi | [2]
5. Noise
Noise rms pada laju terpilih | 0.400 | g rms | nV / (nV/g) | [2] Avia: noise masukan
Noise 10 SPS | 0.400 | g rms |  | [2]
Noise 80 SPS | 0.720 | g rms |  | [2]
Noise dalam count (laju terpilih) | 21.475 | count rms |  | [2]
Noise puncak-ke-puncak (6,6 sigma) | 2.640 | g |  | Aturan 6,6 sigma (praktik umum)
Bit bebas-noise pada beban maksimum | 14.695 | bit | log2(rentang / p-p) | [2]
6. Rata-rata dan waktu
Interval sampel | 100.0 | ms |  | [2] Avia: laju data
Sampel selama tahan | 40 | sampel |  | -
Waktu pembuangan pembacaan awal | 400 | ms |  | -
Noise setelah rata-rata 1 s | 0.126 | g rms | sigma/akar N; hanya jika noise putih | Rata-rata sampel bebas
Noise setelah rata-rata selama tahan | 0.063 | g rms |  | -
7. Margin beban
Beban maksimum / kapasitas | 0.875 | - |  | [5]
Batas aman mekanis | 96.000 | kgf | Konservatif | [6] overload aman
Margin terhadap batas aman | 1.371 | x |  | [6]
Batas destruktif | 120.000 | kgf |  | [6] overload destruktif
Beban maksimum | 686.466 | N | kgf x 9,80665 | Konstanta standar
8. Daya dan arus
Arus eksitasi jembatan | 12.500 | mA | V/R | Hukum Ohm; [6] resistansi masukan
Arus total jembatan + HX711 | 14.000 | mA | Masukkan ke anggaran daya ESP32 | [2] arus HX711
Anggaran galat (dalam gram pada kapasitas penuh)
Kolom "Masuk RSS" (biru, kuning): 1 = ikut digabung, 0 = dihapus oleh tare atau kalibrasi. Ubah sesuai prosedur.
Sumber galat | Besar (g) | Masuk RSS (1/0) | Dihapus oleh | Catatan | Referensi
Error gabungan load cell | 24.00 | 1 | - | Linearitas + histeresis + repeatabilitas; nilai Eagle Weigh | [5] Eagle Weigh
Zero balance | 800.00 | 0 | Tare | Offset awal | [6] GJ Impex
Toleransi sensitivitas | 6000.00 | 0 | Kalibrasi | +-0,15/2,0 = 7,5% dari skala | [5] Eagle Weigh
Efek suhu load cell | 24.00 | 1 | - | Nol + span, kasus terburuk | [6] GJ Impex
Drift offset HX711 | 0.48 | 1 | - | nV/C x dT / (nV/g) | [2] Avia
Noise HX711 (laju terpilih) | 0.40 | 1 | - | 1 sigma | [2] Avia
Creep selama 30 menit | 20.00 | 0 | Durasi tahan beberapa detik | Tidak relevan untuk genggam 3-5 s; relevan untuk beban kalibrasi lama | [6] GJ Impex
Efek kemiringan housing | 140.00 | 0 | Tare pada postur akhir | m x (1 - cos teta) | Asumsi; massa dari blok Mekanik
Gabungan RSS (yang ikut) | 33.95 |  |  | Akar jumlah kuadrat
Gabungan sebagai % kapasitas | 0.042%
Gabungan pada beban tipikal (% pembacaan) | 0.11% |  |  | Beban tipikal dari Input
Gabungan pada beban maksimum (% pembacaan) | 0.05%
Catatan: ini batas bawah ketidakpastian. Massa kalibrasi, pemasangan, dan beban off-centre menambah galat dan harus diukur.
Kalibrasi: regresi linear massa terhadap hitungan ADC
Legenda: kolom A-B (biru, kuning) diisi dari uji kalibrasi. Data di bawah adalah CONTOH rekaan untuk memperlihatkan format, BUKAN hasil ukur. Hapus dan ganti dengan data Anda.
Massa (kg) | Hitungan ADC (rata-rata) | Prediksi (kg) | Residu (g)
0 | 120040 | -0.001 | -0.8 |  | Hasil | Nilai | Satuan
5 | 388520 | 5.000 | 0.1 |  | Kemiringan (kg per count) | 1.86268203e-05 | kg/count
10 | 657010 | 10.001 | 1.2 |  | Faktor skala k | 0.0186 | g/count
15 | 925350 | 15.000 | -0.4 |  | Offset N0 (count pada 0 kg) | 120082.6615 | count
20 | 1193890 | 20.002 | 1.6 |  | R kuadrat | 1.000000 | -
22 | 1301080 | 21.998 | -1.8 |  | Galat baku regresi | 1.4 | g
 |  |  |  |  | Galat baku kemiringan (relatif) | 7.423892847e-05 | -
 |  |  |  |  | Count/g terukur | 53.69 | count/g
 |  |  |  |  | Selisih dari faktor ideal (Hitung) | -0.001979972102% | -
Cara pakai: W(g) = (N - N0) x k. Tare menyetel N0 ulang sebelum tiap pengukuran. Titik di antara 3-5 massa mati, naik dan turun (histeresis).
