raden-ayu44/embedded-systems-finpro/pcb/kicad/pdf/skema-hgd-v1.pdf

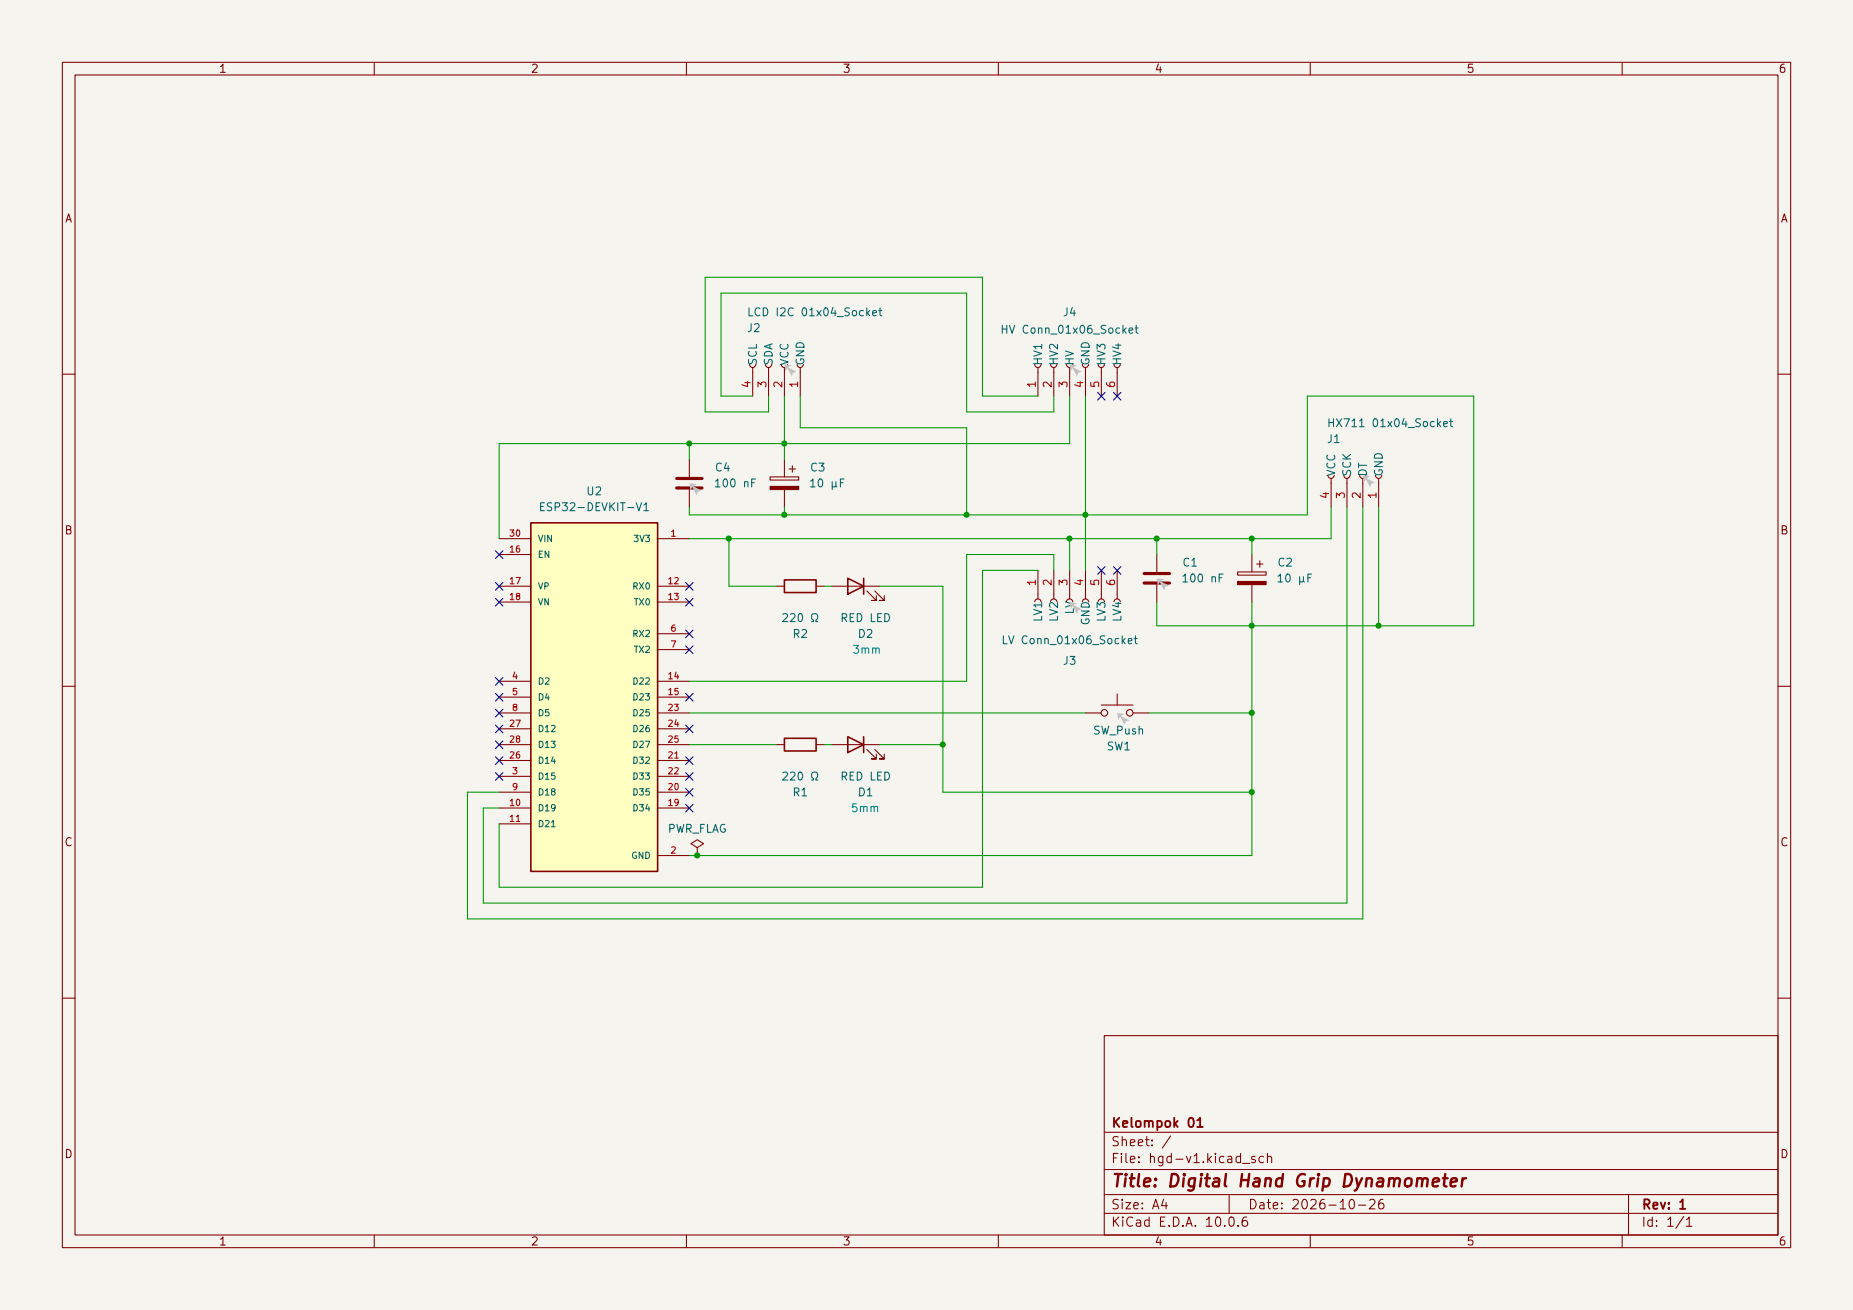
[picture p6: page 1]
