raden-ayu44/embedded-systems-finpro/pcb/kicad/proyek/hgd-v1.kicad_pcb

## KiCad design pcb/kicad/proyek/hgd-v1.kicad_pcb (2026-11-12)

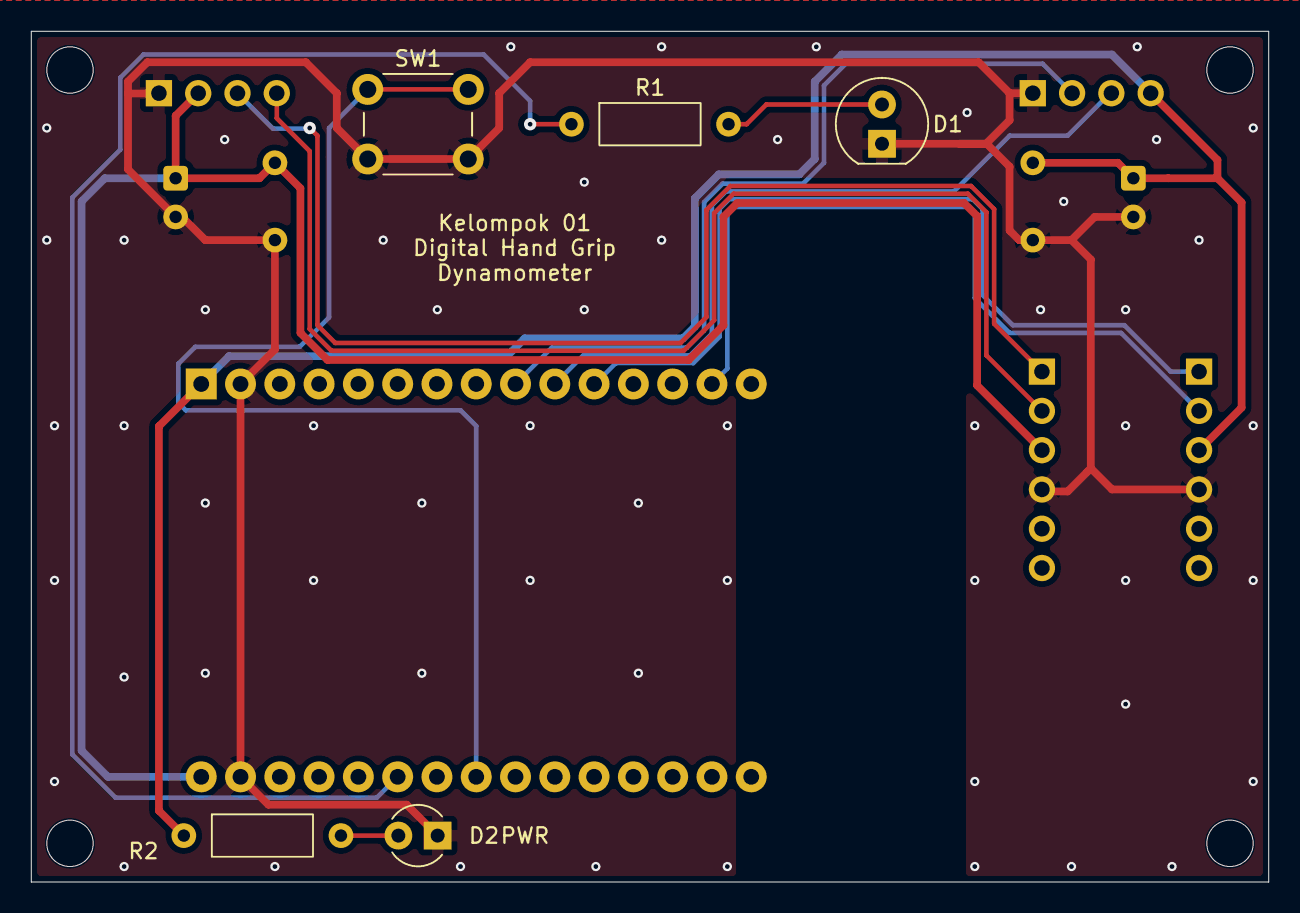
[picture p7: board hgd-v1.kicad_pcb from above]

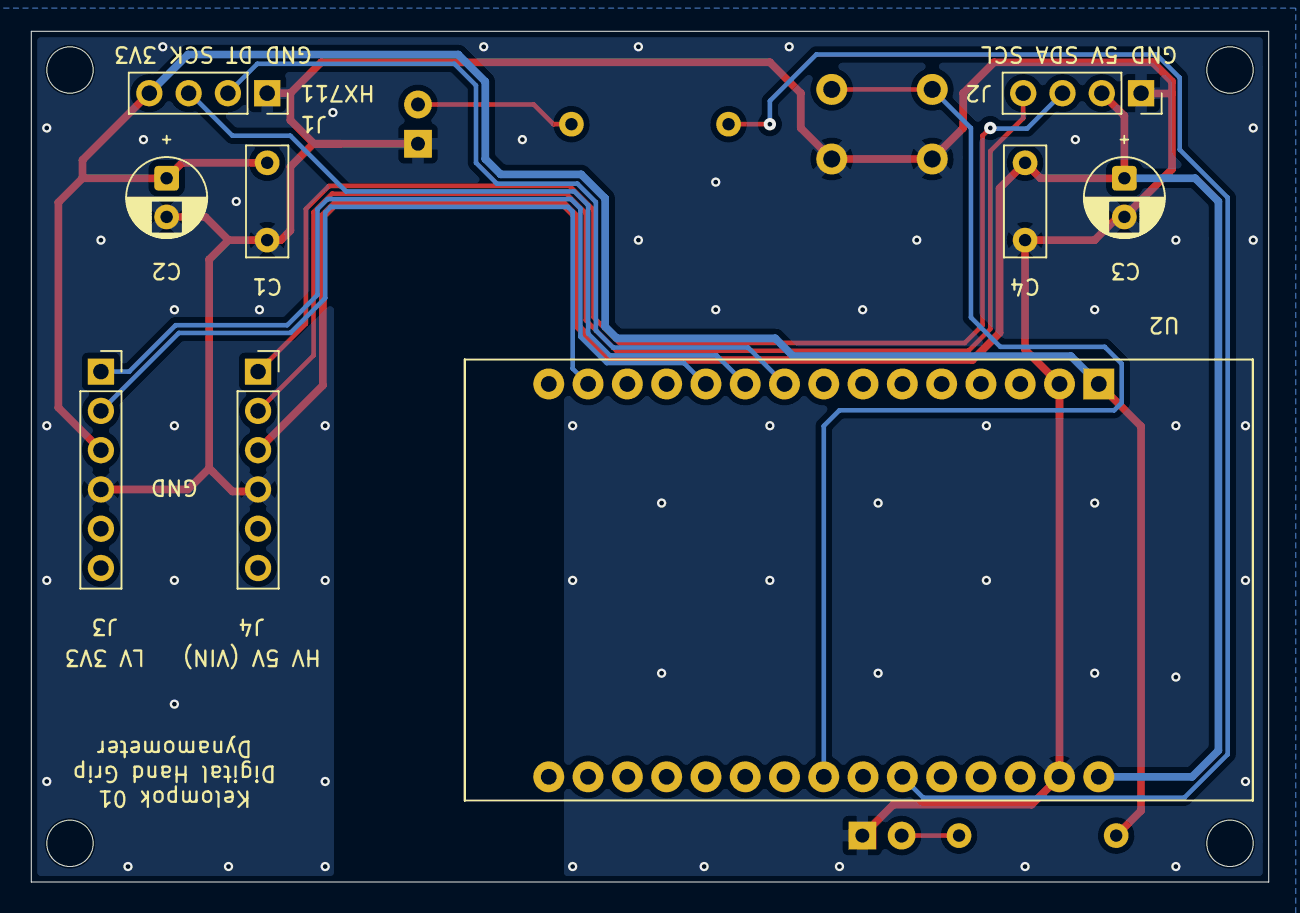
[picture p8: board hgd-v1.kicad_pcb from below]

Board: 2 copper layers, 80.0 x 55.0 mm, 18 parts (9 on the bottom side), 13 nets.

Parts:
C1, C4: 100 nF; C_Disc_D7.0mm_W2.5mm_P5.00mm
C2, C3: 10 µF; CP_Radial_D5.0mm_P2.50mm
D1: RED LED; LED_D5.0mm
D2: RED LED; LED_D3.0mm
H1, H2, H3, H4: MountingHole_3mm
J1: HX711 01x04_Socket; PinSocket_1x04_P2.54mm_Vertical
J2: LCD I2C 01x04_Socket; PinSocket_1x04_P2.54mm_Vertical
J3: LV Conn_01x06_Socket; PinSocket_1x06_P2.54mm_Vertical
J4: HV Conn_01x06_Socket; PinSocket_1x06_P2.54mm_Vertical
R1, R2: 220 Ω; R_Axial_DIN0207_L6.3mm_D2.5mm_P10.16mm_Horizontal
SW1: SW_Push; SW_PUSH_6mm_H13mm
U2: ESP32-DEVKIT-V1; MODULE_ESP32_DEVKIT_V1

Connections:
GND: C1.2, C2.2, C3.2, C4.2, D1.1 (K), D2.1 (K), J1.1 (GND), J2.1 (GND), J3.4 (GND), J4.4 (GND), SW1.2, U2.2 (GND), U2.29 (GND)
unnamed: D1.2 (A), R1.2
unnamed: D2.2 (A), R2.2
unnamed: J1.2 (DT), U2.9 (D18)
unnamed: J1.3 (SCK), U2.10 (D19)
unnamed: C1.1, C2.1, J1.4 (VCC), J3.3 (LV), R2.1, U2.1 (3V3)
unnamed: J2.4 (SCL), J4.2 (HV2)
unnamed: J2.3 (SDA), J4.1 (HV1)
unnamed: C3.1, C4.1, J2.2 (VCC), J4.3 (HV), U2.30 (VIN)
unnamed: J3.1 (LV1), U2.11 (D21)
unnamed: J3.2 (LV2), U2.14 (D22)
unnamed: SW1.1, U2.23 (D25)
unnamed: R1.1, U2.25 (D27)
