raden-ayu44/embedded-systems-finpro/(commit log)

2026-10-15 Hasil uji bench, catu LCD 5 V + level shifter, PCB hgd-v1, housing elektronik
    - Catatan proyek v44: hasil uji 15 Okt. 2026, keputusan catu LCD, BOM level shifter, risiko R11/R12/R15
    - Desain PCB v2: R1 220 ohm, rail +5V, soket di sisi bawah, netlist hgd-v1, usulan penempatan v2 dan gambar SVG
    - Alur program v3: U4, U5, U7, U8 sebagian, E1 (sigma 38,2 counts; ambang onset 1,0 kg), data A5 dan A12
    - Housing elektronik v2 dengan parameter Fusion dan kompensasi susut
    - Tabel pengukuran LCD dan HX711, DS-LLS1, sketsa uji_bench_hgd
    Claude-Session: https://claude.ai/code/session_015Z5tJC56ToSqz8r7EkyAzt
2026-10-16 PCB hgd-v1 v1: gambar papan berjalur dan skema KiCad
    - pcb/gambar/penempatan-pcb-hgd.svg diganti dengan PCB v1 final dari berkas
    KiCad: gabungan, F.Cu saja, B.Cu saja dengan silkscreen bawah.
    - pcb/kicad/proyek/hgd-v1.kicad_sch ditambahkan.
    - desain PCB v3, README KiCad v3, catatan proyek v46.
    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
2026-10-16 Housing elektronik v3: gambar model Fusion dan usulan bibir
    - housing-elektronik/gambar/housing-elektronik-hgd.svg: proyeksi STEP
    electronics_housing_v1 (atas tanpa lid, depan, kiri, kanan, isometrik)
    dengan usulan dinding pada lid, bibir pada body, tiang sudut M2,5,
    takik USB dan kabel load cell, serta detail potongan bibir.
    - Desain housing elektronik v3 (Bagian 1.2), catatan proyek v46.
    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
2026-10-16 Housing elektronik: gambar dari STEP Fusion terbaru, usulan bibir
    Gambar housing-elektronik-hgd.svg dibuat ulang dari ekspor Fusion 16 Okt.
    2026 22:30 (lid berdinding, body baki, jendela USB dan kabel) dengan PCB
    hgd-v1-verbatim (soket 1x15). Usulan bibir disesuaikan: cincin 1,6 x 3,0
    di body dengan tumpuan 45°, celah 0,25 per sisi. Bagian 1.2 diperbarui.
    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
2026-10-16 Housing elektronik v4: usulan snap-fit dan gambar bergaya housing load cell
    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
2026-10-16 Housing elektronik: instruksi kerja Fusion snap-fit, parameter, tiang korban
    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
2026-10-17 Level shifter sudah tiba: status di desain PCB, catatan proyek, datasheet library
    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
2026-10-17 Protokol uji bench: wiring level shifter dan cek tegangan sisi LV
    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
2026-10-17 PR 5 rapikan: status housing dimodelkan, posisi saat ini, protokol bench v2, hub KiCad
    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
2026-10-17 Housing elektronik: catatan filamen lab (PLA Basic dan Generic PLA)
    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
2026-10-17 Housing elektronik: hasil slice uji dan keputusan support jendela ke laboran
    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
2026-10-17 PCB hgd-v1: gambar penempatan diperbarui dari berkas papan terbaru (Gerber diekspor 17 Okt. 2026)
    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
2026-10-17 PCB hgd-v1: teks gambar penempatan diambil dari silkscreen berkas KiCad
    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
2026-10-17 PCB hgd-v1: catatan gambar penempatan dan ekspor Gerber di dokumen
    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
2026-10-17 PCB hgd-v1: LED daya D2, ERC bersih, hitungan pull-up I2C dan cek level shifter terukur
    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
2026-10-17 Uji breadboard: tanpa perbedaan dari skema; LED daya D2 diuji
    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
2026-10-17 PCB hgd-v1: pour GND dua lapis dan via jahit
    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
2026-10-17 PCB hgd-v1: nomor tim dan nama proyek di silkscreen
    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
2026-10-17 PCB hgd-v1: keputusan lubang mounting dicatat
    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
2026-10-17 PCB hgd-v1: alasan lubang mounting
    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
2026-10-17 PCB hgd-v1: berkas papan KiCad terbaru (model 3D DevKit tertanam)
    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
2026-10-17 PCB: KiCad diizinkan sebagai pengganti EasyEDA
    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
2026-10-17 PCB hgd-v1: log kerja KiCad (langkah 1-3) dan skema terbaru
    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
2026-10-17 Log kerja KiCad: langkah 4 (skema ke repo)
    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
2026-10-17 PCB hgd-v1: Gerber diekspor ulang dan dicek
    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
2026-10-17 Log kerja KiCad: langkah 5 (plot Gerber dan bor, dengan setelan)
    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
2026-10-17 Log kerja KiCad: langkah 6 (cek viewer fabrikator)
    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
2026-10-17 PCB hgd-v1: title block papan, salinan 3D verbatim, dan STEP rakitan
    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
2026-10-17 Housing elektronik: STEP model terbaru (bibir dan snap-fit)
    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
2026-10-17 Status WIP: skema, PCB, dan housing elektronik v1 selesai (belum disetujui)
    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
2026-10-17 PCB hgd-v1: gambar penempatan dari papan final (D2/R2, pour GND, via)
    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
2026-10-18 firmware: kerangka proyek HGD (langkah 0)
    Proyek PlatformIO dengan src_dir = hgd sehingga folder sketsa yang sama
    dapat dibuka di Arduino IDE. Banner versi core dan LED kedip 1 Hz memakai
    millis(). Terkompilasi di PlatformIO (core 2.0.17) dan arduino-cli (core 3.3.11).
2026-10-18 docs: alur program v5
    Aturan LED baru (plateau, tahan sampai dilepas, kedip restart) menggantikan
    S5; S2 menjadi 500 ms; reset total 15 s; batas 80 kg dengan cek live di
    GENGGAM; baca HX711 non-blocking tanpa library; galat READING_INVALID;
    pemetaan nama ke identifier bahasa Inggris; build PlatformIO + Arduino IDE;
    logger.py meneruskan tombol dan mencetak baris non-HGD; layar GAGALSIMPAN
    bergantian; uji galat X1-X5 dan X11 diperbarui. A5-A8 selesai.
2026-10-18 firmware: config, types, dan modul tombol (langkah 1)
    config.h memuat pin dan semua konstanta v5; types.h memuat enum dan struct
    sesi. Modul tombol: ISR FALLING dengan debounce 50 ms, debounce saat lepas
    (HIGH stabil 50 ms), TAP hanya bila pin pernah terbaca LOW, TAHAN 1,5 s
    sekali per tekanan, buttonReset() menandai tekanan berjalan sebagai
    abaikan-sampai-dilepas, dan buttonHeldMs() untuk reset total. hgd.ino
    berisi uji langkah 1.
2026-10-18 docs: alasan interrupt tombol diperbarui (alur program v5)
    Bagian 5.3 dan 15.2: interrupt menangkap awal tepat setiap tekanan walau
    loop() sibuk; tekanan harus terbaca LOW sekali oleh loop() lalu HIGH
    stabil 50 ms. Alasan v4 (blocking HX711) dicoret karena tidak berlaku lagi.
2026-10-18 docs: sisa v4 di alur program diselaraskan dengan kode; platform dipatok
    Bagian 4: logika tombol v5 (debounce saat lepas, sawLow, abaikan sampai
    dilepas; A12 ditangani di kode, menunggu uji U8), fault.cpp non-blocking,
    READING_INVALID dan cek live 80 kg, watchdog enableLoopWDT/feedLoopWDT.
    Diagram 6.6: READING_INVALID dan reset total. Bagian 1.4a, 2, 3.1, 5.1,
    5.2, 5.4, 5.17, 6.1, 11.1, 11.3, 12.1 disesuaikan dengan config.h,
    types.h dan button.*. platformio.ini: espressif32 @ 7.1.2 (core 2.0.17).
2026-10-23 firmware: modul display LCD (langkah 2)
    lcdLine() memotong teks di 16 karakter dan mengisi spasi, selalu
    setCursor(0, row), tanpa lcd.clear() untuk redraw, hanya ASCII cetak,
    dan melewati baris yang isinya tidak berubah. displayDue() membatasi
    redraw ke LCD_REFRESH_MS (500 ms); displayRequest() untuk ganti layar.
    hgd.ino: uji LCD (potong teks, angka memendek) plus lama redraw dan
    putaran loop() terlama di Serial; uji tombol langkah 1 tetap jalan.
2026-10-23 firmware: modul sensor HX711, baca non-blocking dan tare (langkah 3)
    sensor.cpp: hxRead() bit-bang tanpa library (diadaptasi dari sketsa
    uji_bench_hgd), hanya saat DT sudah LOW, 25 pulsa dalam noInterrupts().
    Tare 10 sampel lintas loop(), kg = (raw - offset) / skala, buffer
    melingkar 5 sampel, sensorPlateau() dan sensorBufAvg().
    hgd.ino: uji langkah 3 (baris per sampel, LCD kg/raw, TAP atau 't' tare
    ulang, 'p' cetak nilai, laju sampel dan loop terlama tiap 5 s).
    Terukur: hxRead 92-114 us (biasanya 93-95 us), ~11,6 sampel/s, sebaran
    tare 89-109 counts. Alur program 5.7, 6.4, 7.1, 14 dan A5: angka
    "50-60 us" diganti hasil ukur.
2026-10-23 firmware: cek galat sensor HX711 (langkah 4)
    sensorCheck() menghitung galat dari data terakhir, jadi kembali normal
    sendiri setelah kabel dibetulkan. Prioritas: HX711_TIMEOUT (tanpa sampel
    1 s) > ADC_SATURATED (|raw| >= 0,95 x ADC_MAX) > READING_INVALID (10 raw
    identik berturut-turut). faultName() di types.h untuk pesan serial.
    hgd.ino: tiap perubahan galat dicetak sekali dengan waktunya, LCD
    menampilkan teks galat (Bagian 10.2) dan raw; baris per sampel hanya
    saat normal supaya serial tidak banjir.
2026-10-23 firmware: READING_INVALID dari jarak antarsampel pendek (langkah 4b)
    Uji SCK tercabut: DT tertahan LOW, sampel sampah terbaca tiap putaran
    loop(), dan aturan 10 raw identik saja membuat galat berkedip ~130 kali
    dalam 20 s (nilai sampah seperti 4194300 = 78,9 kg sempat lolos).
    Aturan utama baru: SHORT_GAP_N (3) sampel berturut-turut masing-masing
    datang < SAMPLE_MIN_GAP_MS (40 ms) setelah sebelumnya; normal ~85 ms
    pada 10 SPS. Tiga, bukan satu, supaya satu baca terlambat tidak memicu
    galat palsu yang mulai langkah 8 terkunci. Aturan 10 identik tetap
    sebagai cadangan. Urutan: TIMEOUT > jarak pendek > SATURASI > identik.
    Alur program 3.1, 5.7, 7.4, 11.2 (X1b), 14 dan 1.4a diperbarui.
    Co-Author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
2026-10-23 firmware: LCD pulih sendiri, tare diulang bila tersentuh (langkah 4c)
    display.cpp: tiap LCD_HEAL_MS (2 s) satu baris buffer "tampil" ditandai
    tidak diketahui (bergantian), jadi baris itu dikirim ulang penuh pada
    putaran berikutnya (tetap satu baris per putaran, <= 28 ms), tanpa
    delay(). Tanpa ini, gangguan I2C yang mengacaukan layar tidak pernah
    diperbaiki karena karakter "tidak berubah" tidak dikirim lagi.
    sensor.cpp: sebaran tare > TARE_MAX_SPREAD (1000 counts ~ 19 g; normal
    67-127) -> peringatan, offset lama dipertahankan, tare diulang otomatis
    (layar tetap "Nol-kan..."). Komentar waktu hxRead diperbarui ke hasil
    ukur ~93-114 us. Alur program 5.8 dan 5.18 diperbarui.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
2026-10-23 firmware: kerangka state machine dan modul LED (langkah 5)
    fsm.cpp: tujuh state (READY, GRIP, COMPUTE, REST, SUMMARY, FAULT,
    SAVE_FAILED), satu handler per state lewat switch di fsmRun(), satu
    enterX() per state, teks LCD per state (Bagian 10.2) di drawScreen().
    Urutan fsmRun(): reset total (tahan 15 s, hitung mundur mulai detik
    ke-3) -> transisi pengecualian galat sensor dari siklus percobaan ke
    FAULT -> handler -> layar. Transisi sederhana: onset -> fase 2, plateau
    pada t >= 3 s -> COMPUTE -> REST (LED tetap menyala sampai dilepas) ->
    TAP -> percobaan berikutnya; setelah 3 -> SUMMARY -> TAP -> sesi baru.
    FAULT -> TAHAN -> READY dengan kedip, nomor percobaan tetap.
    led.cpp: ledSet(), kedip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
2026-10-23 firmware: penjaga nol di READY/GRIP dan tare ulang manual (langkah 5c)
    - READY setelah tare: kg > +1 -> "Lepas genggaman", START diabaikan;
    kg < -1 -> nol diambil saat dibebani, tare ulang otomatis.
    - GRIP fase 1: kg < -1 -> kembali ke READY (tare ulang).
    - TAHAN 1,5 s di READY = tare ulang manual; reset total 15 s tetap.
    - 5 sampel HX711 pertama setelah boot dibuang (tare pertama gagal di
    tiga boot berturut-turut); kg dihitung ulang dengan offset baru.
    - Dokumen: 5.8, 6.2, 6.3, 6.5, 10.2.
2026-10-23 firmware: GRIP fase 1 tampilkan kg dua desimal dan target onset (langkah 5c)
    Baris 2 "Menunggu genggam" kini " 0.42 kg >1.0": dengan satu desimal
    tekanan kecil tetap tampil 0.0, jadi penggenggam tidak tahu seberapa jauh
    lagi dari onset. Dokumen 10.2 diperbarui.
2026-10-23 firmware: logika GRIP lengkap (langkah 6)
    - Dilepas sebelum 3 s (kg < onset) -> kembali ke fase 1, buffer
    dikosongkan, LED mati, percobaan tidak dihitung.
    - Plateau genggaman: buffer stabil DAN semua 5 sampel > onset; tangan
    yang sudah lepas tidak lagi terbaca sebagai plateau (uji langkah 5:
    ref -0,05 kg).
    - Batas 5 s tanpa plateau -> COMPUTE dengan rata-rata jendela 5 sampel
    paling stabil selama fase 2 (nilai buffer terbaik), LED mati.
    - Log [GRIP] exit=EARLY_RELEASE / PLATEAU / TIMEOUT; [COMPUTE] menyebut
    jalur keluar. API sensor: sensorBufFull, sensorBufSpread, sensorBufMin.
    - Dokumen: 5.11, 6.2, 6.3.
2026-10-23 firmware: TAHAN di GRIP fase 1 = kembali ke READY dengan tare ulang (langkah 6c)
    Menolkan ulang tanpa harus menyelesaikan percobaan: di "Menunggu genggam"
    TAHAN 1,5 s kembali ke READY (tare ulang, tanpa kedip, nomor percobaan
    tetap). Di fase 2 tombol tetap diabaikan. Dokumen 6.2, 6.3, 6.5.
2026-10-23 firmware: TAHAN di GRIP fase 1 = tare ulang di tempat (langkah 6c)
    Tetap di "Menunggu genggam"; baris 2 "Menyesuaikan nol" sampai tare
    selesai (~1 s), lalu kg live lagi. Onset dan penjaga nol tidak dinilai
    selama tare (kg masih memakai offset lama). Dokumen 6.2, 6.3, 6.5, 10.2.
2026-10-23 firmware: hitung mundur istirahat di REST (langkah 7)
    Setelah genggaman dilepas: "Lepas>Rest %2lus" menghitung mundur REST_S
    (60 s) dari millis(), dibulatkan ke atas, digambar ulang tiap 500 ms;
    tombol diabaikan selama istirahat. Pada 0 -> "NEXT > lanjut" /
    "NEXT > ringkasan". Log [REST] dilepas / istirahat selesai. Dokumen 6.2.
2026-10-23 firmware: modul galat dan cek rentang (langkah 8)
    - fault.h/.cpp: faultEnter (LED mati, [FAULT] jenis raw kg, baris E),
    faultDraw ("ERR:..." + RAW live), faultClear, faultLogEvent.
    fsm.cpp tetap memutuskan kapan masuk/keluar FAULT.
    - OUT_OF_RANGE: live di GRIP (kg > 80 kg pada sampel mana pun) dan pada
    ref di COMPUTE (ref <= 0 atau > 80 kg; percobaan tidak dihitung).
    - Baris E juga untuk reset total (kode 5, sesi/percobaan sebelum reset).
    Sampai langkah 9 dicetak sebagai teks [E].
    - Perintah x: skala dibagi DEMO_SCALE_DIV (40) sampai tare berikutnya.
    - TARE_MAX_SPREAD 1000 -> 400 counts.
    - Dokumen: 4.6, 5.8, 5.21, X3.
2026-10-23 firmware: penjaga nol memakai skala normal (langkah 8b)
    Setelah x, kg terskala 40x: lekukan -0,13 kg di awal tekanan terbaca
    -5 kg, mengembalikan GRIP ke READY, dan tare ulangnya membatalkan x.
    sensorKgReal() = (raw - offset) / SCALE_COUNTS_PER_KG dipakai hanya oleh
    penjaga nol di READY dan GRIP fase 1 (dan layar "Lepas genggaman").
    Onset, plateau dan cek 80 kg tetap memakai kg terskala. Dokumen 6.2.
2026-10-23 firmware: simulasi X2, jendela offset tare, x bertahan (langkah 8c)
    Keputusan review:
    - Perintah s (bolak-balik): raw dipaksa skala penuh -> ADC_SATURATED lewat
    jalur galat normal. X2 dicatat sebagai simulasi (kabel load cell disolder
    langsung ke HX711).
    - Jendela offset saat tare: |offset - OFFSET_EXPECTED| > OFFSET_WINDOW
    (-39000 +- 20000, khusus unit, diukur ulang saat kalibrasi) ->
    READING_INVALID, serial "offset di luar jendela". Menangkap E- terputus
    (offset ~+500) dan pasangan sinyal tertukar (~+39000). Batas: putus di
    tengah percobaan tertangkap pada tare berikutnya.
    - x bolak-balik dan bertahan melewati tare; mati oleh sesi baru, reset
    total, atau x lagi. READY "SIAP x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
2026-10-23 firmware: offset di luar jendela mula-mula = tare terganggu (langkah 8d)
    Temuan review: jendela +-20000 counts (~0,37 kg) langsung memicu
    READING_INVALID bila tare diambil dengan tangan di load cell (kasus yang
    ditangani lembut di 5c), dan pelat B rakitan (~7400 counts) memakan
    margin. Kini offset di luar jendela: offset lama dipertahankan, layar
    "Lepas genggaman", tare diulang. Baru setelah OFFSET_BAD_N (3) tare
    berturut-turut di luar jendela -> READING_INVALID ("load cell
    terputus?"). E- terputus tetap ~+500 di setiap ulangan, jadi tetap
    tertangkap. Diuji dengan build sementara (harapan +39000): 1/3, 2/3,
    lalu FAULT READING_INVALID 1,7 s kemudian. Dokumen 5.8, 7.4.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
2026-10-23 firmware: offset di luar jendela berbasis waktu (langkah 8d)
    3 tare hanya ~1,7 s, jadi tangan yang bertumpu 2 s akan menjadi FAULT.
    Kini READING_INVALID hanya bila offset di luar jendela terus-menerus
    selama OFFSET_BAD_MS (10 s); sementara itu tare diulang dengan layar
    "Lepas genggaman", dan satu tare di dalam jendela mengembalikan hitungan
    waktu. Diuji dengan build sementara (harapan +39000): FAULT 10,2 s
    setelah peringatan pertama. Dokumen 5.8, 7.4.
2026-10-23 firmware: pengguna memilih kapan lepas antara 3 dan 5 s (langkah 6d)
    Temuan uji: genggaman stabil selalu berhenti tepat 3 s karena plateau
    mengakhiri percobaan. Kini plateau tidak lagi mengakhiri percobaan:
    - dilepas < 3 s -> fase 1 (tetap); dilepas 3-5 s -> COMPUTE; masih
    digenggam pada 5 s -> COMPUTE. Semua memakai THRESHOLD_ONSET_KG (kg < 1).
    Mengikuti "Tahan 3-5 detik" di proposal.
    - ref = jendela stabil terkuat; bila tidak pernah stabil, jendela terkuat.
    - LED = plateau; pada batas 5 s tetap menyala bila stabil sampai dilepas.
    - LCD fase 2: sejak 3 s dan stabil, " 25.3kg Lepas ok" (16 karakter).
    - GripExit: EXIT_PLATEAU diganti EXIT_RELEASE; Trial.steady.
    - Dokumen 5.11, 6.2, 6.3, 1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
2026-10-23 laptop: logger.py (CSV harian, ACK/NAK) dan uji U9/U10/E5 (langkah 10)
    - laptop/logger.py: baca baris HGD, validasi awalan/kolom/checksum, tulis
    hgd_YYYYMMDD.csv + flush, balas ACK/NAK; baris non-HGD dicetak ke
    konsol; tombol t p x s u r diteruskan ke ESP32 (msvcrt). Port dibuka
    dengan RTS/DTR mati (tidak me-reset ESP32); duplikat karena ACK hilang
    tidak ditulis ulang; sampah sebelum "HGD," dilewati; opsi uji --kirim.
    - .gitignore: hgd_*.csv (data pengukuran tidak masuk repo publik).
    - Firmware: perintah u (100 baris uji U, waktu ACK terlama/rata-rata) dan
    r (satu baris rusak). E5: 4 x 100/100 ACK, terlama 33,3 ms ->
    ACK_TIMEOUT_MS 500 ms (10x = 333 ms, batas bawah 500 ms).
    - U10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
2026-10-23 laptop: tulis CSV sebelum ACK, NAK bila gagal tulis (langkah 10b)
    - ACK berarti "sudah tertulis" (4.8): baris ditulis, flush dan fsync
    dulu, baru ACK. Berkas dibuka-tulis-tutup per baris; gagal tulis (mis.
    PermissionError karena CSV dibuka di Excel) -> galat dicetak, NAK, ESP32
    mengirim ulang lalu GAGAL SIMPAN; logger.py tetap berjalan. Diuji
    dengan CSV read-only: NAK dua kali, CSV tidak berubah.
    - laptop/__pycache__ dihapus dari git; __pycache__/ di .gitignore.
    - Petunjuk menjalankan: --dir ..\data (CSV di samping repo, bukan di
    dalamnya). Uji X14 baru (CSV dibuka di Excel). Dokumen 9.4, 11.2, 12.2.
2026-10-24 dok: tabel teks LCD untuk ditinjau (langkah 10)
    - firmware/teks-lcd-hgd.md: semua layar LCD persis seperti dicetak
    firmware (baris 1/2, jumlah karakter, format di kode), dengan nama
    state dokumen dan nama di kode. Rujukan utama tetap Bagian 10.2.
2026-10-24 firmware: perbaikan uji papan langkah 10 (pesan NAK, Data tersimpan, dua desimal)
    - serial_log: pesan "sisa baris ringkasan tidak dikirim" mencetak alasan
    sebenarnya (seq N gagal: NAK / tanpa ACK), bukan selalu "logger.py
    tidak menjawab" (salah setelah NAK karena CSV dibuka di Excel).
    - RINGKASAN setelah semua ACK: baris 2 bergantian "Data tersimpan" /
    "Tekan: RESTART" tiap SUMMARY_PAGE_MS (2 s). "Menyimpan..." hanya
    < 0,1 s dengan logger.py; tanpa penundaan buatan, TAP langsung berlaku.
    - LCD: semua kg dua desimal (%5.2f). GENGGAM fase 1 " 0.42kg >1.00kg";
    RINGKASAN "Mx47.23 Av44.81" (tanpa kg supaya muat 16); GAGALSIMPAN
    tiga halaman (P1/P2, P3, Mx/Av); label puncak "Mx" di sem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
2026-10-24 firmware: nomor boot, rekaman genggaman G dan penanda M (langkah 10c)
    - serial_log: semua baris "HGD,<jenis>,<seq>,<boot>,..."; boot = 4 digit
    heksadesimal acak per nyala (logInit), supaya baris yang sama setelah
    reset tidak dianggap duplikat oleh logger.py. enqueue() generik.
    - Baris G (tanpa ACK, seq 0): tiap sampel HX711 selama GRIP (upaya, ms
    sejak upaya mulai, kg, fase 0/1/2, demo); saklar LOG_RAW di config.h.
    - Penanda M (dengan ACK) per upaya genggam: sesi, percobaan, upaya,
    keluar, onset/akhir, jendela ref, ref, puncak, demo, galat, n.
    Penanda yang gagal hanya dibuang dengan peringatan, tidak pernah
    GAGAL SIMPAN; logBatchStart() membuang penanda yang masih di depan.
    - fsm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
2026-10-24 firmware: komentar keselarasan winTimes dan buffer plateau (tinjauan PR #9)
    Saat onset buffer plateau di-reset dan winNext = 0, jadi sampel onset
    tidak ada di keduanya; keduanya mulai dari sampel berikutnya. Hanya
    komentar, logika tidak berubah.
2026-10-24 firmware: tanpa istirahat setelah percobaan 3 (opsi A)
    - handleRest(): percobaan 3 dilepas -> LED mati, langsung sub-fase 2
    ("NEXT > ringkasan"), tanpa hitung mundur. Istirahat ada untuk
    pemulihan otot sebelum genggaman berikutnya; setelah percobaan 3 tidak
    ada genggaman lagi. Hasil percobaan 3 tetap tampil di baris 1.
    - LCD sebelum dilepas: "Lepas>ringkasan" (gaya "Lepas>Rest"; "Lepas
    genggaman" di SIAP artinya lain).
    - serial_log.cpp: komentar logBatchStart() tidak lagi menyebut istirahat
    sebelum RINGKASAN.
    - Dokumen: alur program daftar perubahan butir 11 (menyimpang dari
    proposal, untuk brief), Bagian 6.1-6.3, 9.5, 10.2, 16; teks-lcd-hgd.md;
    catatan proyek v52.
    - Diuji di p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
2026-10-24 firmware: watchdog, sinkron ulang LCD, batas tampilan kg, log latensi LED (langkah 11)
    - hgd.ino: enableLoopWDT() di akhir setup() (core memberi makan sekali
    setelah tiap loop(), batas 5 s, panic -> reset); perintah debug w
    (loop() sengaja macet, uji X18); boot di keluaran p.
    - display.cpp: tiap 2 s urutan sinkron ulang HD44780 (0x30 x3, 0x20
    nibble; 0x28, 0x0C, 0x06) satu langkah per putaran loop() dengan jeda
    >= 5 ms (millis), tanpa Clear, hanya dimulai bila tidak ada perubahan
    layar yang menunggu, lalu kedua baris dikirim ulang penuh (menggantikan
    heal langkah 4c). Tanpa blocking; putaran terlama <= 30,7 ms.
    - fsm.cpp: lcdKg() membatasi kg di LCD ke -9.99..99.99 dan menulis 0.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
2026-10-24 laptop: logger.py tersambung lagi setelah port hilang (langkah 11)
    - SerialException saat baca/tulis (USB dicabut, alat mati) -> peringatan,
    port ditutup, dibuka lagi tiap 1 s dengan RTS/DTR mati; rekaman
    tertunda tetap di memori; tombol yang diketik selama port hilang
    dibuang. Diuji offline (port tiruan) dan di papan (X5).
    - Tombol w diteruskan (uji watchdog).
2026-10-24 dok: hasil langkah 11, lima skenario galat, E8, build akhir
    - alur-program-hgd.md: 4.9 watchdog, 5.3 ukur ulang loop, 5.18 sinkron
    ulang LCD, 10.1 batas tampilan kg, 3.1 konstanta, 3.3 E8 (latensi LED
    dan rantai lengkap untuk brief), 9.2 uji nomor boot, 11.2 X1a, X1b,
    X5, X8, X17 (aktuator), X18 (watchdog), 12.1 build akhir core 3.3.11,
    12.2 logger tersambung lagi, 18 W4; banner status (dibekukan untuk UTS).
    - catatan-proyek-hgd.md v53.
2026-10-24 dok: penyegaran status dan urutan baca UTS
    - README: status 24 Okt. 2026 (firmware langkah 0-11 diuji dan dibekukan
    untuk UTS, logger bekerja, PCB v1 dan desain housing selesai, kalibrasi
    dipindah ke proyek akhir); folder laptop/ dan firmware/hgd/,
    teks-lcd-hgd.md di tabel folder; bagian "Mulai di sini untuk UTS"
    (urutan baca dan folder yang tidak diperlukan).
    - alur-program-hgd.md: catatan lampiran lama di awal Bagian 15-17
    (Bagian 6 dan 10 berlaku bila berbeda).
    - teks-lcd-hgd.md v2: tidak lagi menyebut cabang feat/logger.
    - catatan-proyek-hgd.md v54: posisi saat ini, Bagian 15.1 (kalibrasi,
    dokumen), 15.2 (firmware dan logger selesai, sisa UTS), peta dokumen;
    kalibrasi bukan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
2026-10-24 dok: arus tiap rail terukur (uji S3 untuk UTS)
    - desain-pcb-hgd.md v5, Bagian 5.1: multimeter seri per kabel catu,
    diam dan puncak: 3V3 D2 6,7 mA, HX711 + LV 10,4 mA; 5 V LCD 26,4 /
    27,0 mA, HV < 0,01 / 0,2 mA; beban luar 43,5 / 44,3 mA; papan DevKit
    diestimasi (55-105 mA: ESP32 30-68 mA dari datasheet ESP32 series,
    Modem-sleep 240 MHz dual-core, radio mati; CP2102 dan regulator nilai
    tipikal, datasheet tidak di repo); total dari USB 100-150 mA,
    memenuhi S3 (rata-rata <= 150, puncak <= 600 mA; puncak 540 mA pada
    estimasi berasal dari Wi-Fi TX yang tidak dipakai). Batas metode dan
    wiring breadboard yang terlihat (sama dengan skema).
    - catatan-proyek-hgd.md v55: verifikasi S3 (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
2026-10-24 dok: protokol pengukuran arus rail (satu multimeter, satu orang)
    - pengukuran/protokol-arus-rail-hgd.md v1, sesuai pengukuran 24 Okt.
    2026: yang diukur dan tidak (papan DevKit, D1, pembacaan sesaat bukan
    rata-rata 30-60 menit); wiring breadboard sampai UTS (dua jumper 3V3
    ke rail atas dan bawah yang tidak tersambung, LCD dan HV langsung dari
    VIN) dengan ujung-ujung tiap sambungan; alat; keselamatan (tidak
    menyentuh pin header DevKit di mode mA, probe lewat ujung jumper atau
    jumper cadangan, semua sambungan dipasang sebelum dinyalakan);
    keadaan diam dan puncak; arah probe, jack, rentang (B1 tidak boleh
    2 mA, B2 2 mA); kontinuitas sebelum tiap penyalaan; tanda dari alat;
    lang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
2026-10-24 dok: panduan menjalankan purwarupa dari nol (laptop mana pun)
    - laptop/panduan-menjalankan-hgd.md v1: perangkat lunak dan versi
    (Arduino IDE, esp32 3.3.11 tanpa update, LiquidCrystal_I2C 1.1.4,
    pyserial 3.5); cek Python yang dipakai dan kasusnya (python.org,
    MSYS2 yang menolak pip, Python PlatformIO yang sudah berisi pyserial);
    VS Code hanya terminal (jangan Upload/Serial Monitor PlatformIO);
    flash dengan Arduino IDE (tanpa BOOT, jangan sentuh papan, tanda
    berhasil, Upload Speed bila gagal); port COM dan arti galatnya;
    logger.py (baris [INFO] awal normal, uji p, Ctrl+C); uji bench satu
    sesi; membuka CSV (VS Code, Excel lewat From Text/CSV dengan
    pengaturan angka Indonesia).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
2026-10-24 dok: pengaturan Tools build UTS di panduan menjalankan
    Core Debug Level None, Flash Frequency 80 MHz, Upload Speed 921600,
    Erase Flash Disabled (nilai bawaan, dari build.options.json build 24 Okt.
    2026); Events Run On tidak ada untuk papan ini; ukuran build IDE dan
    arduino-cli.
2026-10-24 Dokumen: gambar wiring breadboard dan kapasitor C3/C4 ke +5V
    - pengukuran/protokol-arus-rail-hgd.md v2: Bagian 2.1 gambar wiring (Wokwi,
    gambar saja), cara membaca, legenda berbasis posisi; C3/C4 dipindah ke
    +5V sesuai skema dengan hasil cek kontinuitas dan tegangan
    - pengukuran/gambar/wiring-breadboard-hgd.png, pengukuran/wokwi/diagram.json
    - pcb/desain-pcb-hgd.md v6: koreksi "breadboard = skema" untuk kapasitor
    - catatan-proyek-hgd.md v57, README: peta dokumen
2026-10-24 Dokumen: rangkuman semua pembacaan multimeter
    - pengukuran/hasil-multimeter-hgd.md v1: semua pembacaan 10-25 Okt. 2026
    urut tanggal (tegangan rail dan pin modul, resistansi load cell dan
    pull-up, arus rail, kontinuitas, komponen lepas, sinyal jembatan)
    - pembacaan baru: U6 (E+ 2,98 V, E- 0,02 V), R1/R2, C1-C4, arus D1 4,9 mA
    - U6 selesai di alur program, datasheet library, desain PCB v7, catatan v58
    - pemetaan kabel load cell ke HX711: hitam E+, putih E-, hijau A+, merah A-
2026-10-24 Dokumen: selisih 3V3 berasal dari kontak pin 3V3 DevKit ke breadboard
2026-10-25 Dokumen: koreksi penelusuran selisih 3V3 (ukur di lubang berkabel)
2026-10-25 Dokumen: nilai akhir C1/C4 ≈ 105 nF
2026-10-25 Dokumen: mode dioda LED diulang dengan baterai baru; catatan baterai
2026-10-25 Dokumen: penyebab mode dioda tidak stabil (LED di breadboard, baterai)
2026-10-25 Dokumen: R1/R2 diukur ulang di luar breadboard (sama)
2026-10-25 Dokumen: uji bench resmi v2 pada wiring akhir
2026-10-25 Laptop: grafik gaya genggam per sesi (plot_grip.py)
    - laptop/plot_grip.py: gaya terhadap waktu sejak onset untuk tiga percobaan
    satu sesi dari hgd_genggam_*.csv, ambang onset 1 kg, jendela ref; PNG di
    samping CSV; jalan di laptop (pandas + matplotlib) dan Google Colab
    - panduan menjalankan Bagian 9, README
2026-10-25 Laptop: plot_grip.py tidak berjalan sendiri di Colab; cek berkas CSV
2026-10-25 Laptop: grafik per percobaan dan grafik sesi (berurutan, bertumpuk)
    - plot_grip.py: satu gambar per percobaan; panel atas seluruh genggaman
    (tiap sampel, onset, akhir, ambang, jendela ref, puncak, strip LED D1),
    panel bawah perbesaran jendela ref (5 nilai, rentang vs 0,5 kg, ref);
    jendela dihitung ulang dari sampel dan dicek terhadap penanda firmware
    - plot_session.py baru: tiga percobaan berurutan (jeda dari jam laptop)
    dan bertumpuk di onset
    - fungsi per percobaan bernama plot_trials(); panduan Bagian 9, README
2026-10-27 PCB: versi akhir 26 Okt. 2026 (skema, papan, PDF skema, tangkapan)
    - hgd-v1.kicad_sch: judul "Digital Hand Grip Dynamometer" (hanya title block).
    - hgd-v1.kicad_pcb: jalur ulang dengan posisi footprint tetap (56 via GND),
    silkscreen tiga baris, stackup FR4 1,6 mm; folder keluaran Gerber kembali
    ke gerber/ (tanpa jalur lokal).
    - hgd-v1.kicad_pro baru (jalur keluaran relatif di dalam proyek).
    - PDF skema, tangkapan Assign Footprints, ERC, DRC, dan render papan/3D.
    - Desain PCB v8 (Bagian 8.1a daftar Assign Footprints), log kerja KiCad v2,
    README KiCad v6, catatan proyek v59.
    - Gambar penempatan, salinan verbatim, dan STEP tetap versi 17 Okt.;
    Gerber tetap di luar repo sampai disetujui.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
2026-10-27 PCB: STEP 26 Okt. menggantikan STEP dan salinan verbatim 17 Okt.
    - hgd-v1.step diganti ekspor 26 Okt. 2026 dari papan utama (tanpa dua
    soket 1x15 DevKit; soket tidak memengaruhi desain housing).
    - hgd-v1-verbatim.kicad_pcb dihapus (gunanya hanya menampilkan soket di 3D).
    - Desain PCB, log kerja KiCad, README KiCad, catatan proyek diperbarui;
    housing elektronik v6 (catatan model PCB tanpa soket).
2026-10-27 PCB: setelan KiCad langkah demi langkah, hasil JLCDFM, garis waktu
    - Desain PCB Bagian 8.5: Board Setup (stackup, aturan desain, net class),
    routing (lebar jalur, via, kemampuan arus IPC-2221), area antena, pour GND
    (clearance, thermal relief, island), DRC, Plot Gerber, bor, ZIP dan cek
    JLCDFM; diambil dari berkas papan/proyek dan dialog Plot/Drill 26 Okt.
    - Garis waktu dikoreksi: silkscreen dan judul 18-19 Okt.; 26 Okt. tiga
    belokan 45° dan via dijauhkan dari tepi (bukan jalur ulang penuh).
    - Hasil JLCDFM ditulis jelas; daftar silkscreen; revisi v2 (net label,
    garis silkscreen footprint pustaka) di sisa pekerjaan.
    - Log kerja KiCad, README KiCad, catatan proyek menyesuaikan.
    Co-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
2026-10-27 PCB: gambar penempatan versi papan akhir 26 Okt. 2026
    - pcb/gambar/penempatan-pcb-hgd.svg diganti gambar tiga panel (gabungan,
    F.Cu, B.Cu + silkscreen bawah) dari berkas papan 26 Okt.; keterangan dalam
    bahasa Indonesia, istilah teknis dalam bahasa Inggris. Dicek terhadap
    hgd-v1.kicad_pcb: 186 segmen, 58 via, 70 pad, 4 NPTH, silkscreen kedua sisi.
    - Catatan "gambar masih versi 17 Okt." di desain PCB dan catatan proyek
    diganti; log kerja KiCad langkah 15.
2026-10-27 PCB: courtyard C2 dan C3 di gambar penempatan diperbaiki
    Courtyard C2/C3 (CP_Radial_D5.0mm) adalah lingkaran r 2,75 mm di tengah
    antara dua pad, bukan persegi 5,5 mm yang tergeser 2,75 mm. Diperbaiki di
    panel gabungan dan panel B.Cu; courtyard lain sudah cocok dengan berkas papan.
2026-10-27 PCB: jumlah via jahit dan cek JLCDFM di baris status yang tersisa
2026-10-27 Firmware: LED D1 berkedip cepat terus di ERROR dan GAGALSIMPAN
    Usulan tim: penggenggam bisa tidak melihat layar "ERR:..." atau "GAGAL SIMPAN",
    dan alat tidak punya buzzer. Sebelumnya LED dipaksa mati saat galat.
    - led.cpp/.h: mode kedip kedua ledAlarmStart(): 5 Hz (LED_ALARM_MS 100 ms),
    tanpa batas waktu; berhenti lewat ledSet() atau ledBlinkStart().
    Kedip restart 2 Hz / 5 s tetap ada, jadi kedua tanda bisa dibedakan.
    - fault.cpp: faultEnter() memulai kedip alarm (ganti ledSet(false)).
    - fsm.cpp: enterSaveFailed() memulai kedip alarm.
    - config.h: LED_ALARM_MS. Komentar hgd.ino, fault.h, fsm.cpp disesuaikan.
    - Keluar lewat TAHAN 1,5 s atau reset total: enterReady() memulai kedip
    restar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
2026-10-27 Firmware: perbaiki komentar yang menyesatkan (tanpa ubah kode)
    - hgd.ino: judul ringkasan bukan lagi "Langkah 5 (kerangka)"; LED di REST tetap
    menyala hanya bila percobaan berhenti di 5 s saat stabil.
    - fsm.cpp: hapus "Transisi masih sederhana" dari kepala berkas.
    - config.h: daftar perintah DEBUG_CMD yang benar (t, p, x, s, u, r, w; tidak ada k).
    - display.h: teks layar disusun di drawScreen() (fsm.cpp), bukan displayShow().
    - serial_log.h: perintah w ikut didaftar.
    - sensor.h: aturan offset tare di luar jendela ikut di urutan prioritas galat.
    Dikompilasi ulang dari folder bersih (core 3.3.11): berhasil.
2026-10-30 Housing elektronik: slot-U kabel load cell + lidah body (v7)
    HX711 tidak muat lewat jendela kabel 15 x 9 karena kabel load cell
    menyatu. Diganti slot-U dari tepi bawah lid yang ditutup lidah body
    dan menjepit kabel. Parameter cable_d sampai ctongue_h ditambahkan
    ke CSV, gambar usulan di gambar/slot-kabel-load-cell.svg.
2026-10-30 Housing elektronik: parameter housing dan lubang, STEP 30 Okt.
    Slot-U dan lidah sudah dimodelkan dan dicek dari STEP. Parameter
    ukuran housing, jendela LCD dan USB, serta lubang tombol, LED, dan
    lantai ditambahkan ke CSV (diukur dari STEP). STEP di fusion/
    diperbarui ke ekspor 30 Okt.
2026-10-30 Housing elektronik: lubang = ukuran bagian + comp_hole
    Tombol, LED D1/D2, dan akses EN/BOOT dipisah menjadi ukuran bagian
    (btn_d, led1_d, led2_d, enboot_d) dan lubang = ukuran + comp_hole.
    mnt_hole_d tetap 5 dengan catatan selisih terhadap PCB_hole_d +
    comp_hole.
2026-10-30 Housing elektronik: rumus mnt_hole_d = PCB_hole_d + 1 mm + comp_hole
2026-10-31 Housing load cell: pola lubang terukur, lubang spacer Ø7,6 (v11)
    Pola lubang pasang diukur dengan jangka sorong (celah dalam dan
    bentang luar) dan cocok dengan gambar penjual: 12 / 106 / 15 mm.
    Lubang spacer di model memakai hole_d + comp_hole = 7,6 mm supaya
    tercetak sekitar 6,6 mm; comp_hole ditambahkan ke CSV grip.
2026-11-01 Housing load cell: CSV parameter untuk tim pemodel (v12)
    CSV grip disusun ulang seperti CSV housing elektronik: kompensasi
    cetak, posisi lubang sebagai rumus, spacer dengan bibir dan celah
    pas, klem kabel berupa slot jepit terbuka ke bawah (kabel menyatu
    dengan HX711), aturan jarak sisi A ke sisi B. Parameter wajib diberi
    tanda WAJIB; parameter klem lama dihapus.
2026-11-01 Housing load cell: instruksi kerja Fusion v6
    Instruksi kerja lama (v5, bahasa Inggris) sudah usang: tebal 52 mm,
    tanpa pola lubang, klem kabel lama. Ditulis ulang dalam bahasa
    Indonesia mengikuti CSV v12: acuan koordinat, hasil akhir, 10 fase
    (persiapan, load cell acuan, Spacer A, slot jepit, Spacer B, pelat,
    bagian bebas, pemeriksaan, ekspor, cetak uji klem), aturan cetak, dan
    gerbang keputusan.
2026-11-01 Housing load cell: posisi kabel terukur, cable_x 5,3
    Tepi jauh kabel dari muka ujung: 6,7 (didorong ke ujung) dan 8,0 (ke
    tengah), jadi pusat lubang kabel 5,35. Klem memakai cable_x = 5,3
    supaya kabel tidak ditekuk di pangkalnya. Catatan di asumsi.md 8.2,
    instruksi kerja dan changelog desain disesuaikan.
2026-11-01 Housing load cell: pangkal kabel tanpa karet menonjol (dicek 1 Nov.)
2026-11-01 Housing load cell: klem kabel takik + zip tie (v13)
    Dari tata letak HGD.step, kabel ditarik ke arah pelat B menuju housing
    elektronik, tepat ke mulut slot jepit snap-fit. Klem diganti takik
    terbuka ke arah pelat B dan bantalan dengan terowongan zip tie 2,5 x
    100 di dinding Spacer A: menahan ke segala arah, tidak peka toleransi,
    bisa dibongkar. Parameter notch_*, pad_*, tie_*, tun_* menggantikan
    clamp_hole_d dan clamp_mouth_w; instruksi kerja v7.
2026-11-06 Housing load cell: hitungan gaya ulang dengan ukuran terukur (v14)
    HL9 dihitung ulang dengan urutan analisis balok Beer, Johnston, dan
    DeWolf Bab 5 (benda bebas, reaksi, diagram V dan M, sigma = M/S, S_min)
    untuk boss_L 24 (a = 41, x = 106) dan baut flange A2-70 yang dibeli.
    Beban merata di zona genggam memberi lenturan ujung jauh 0,381 mm, sisa
    celah setelah anggaran kira-kira 0,32 mm; tarik ungkit 1 172 N per baut.
    asumsi.md Bagian 2 dan 3, catatan proyek, komentar CSV, dan sitasi (BJ1
    sampai BJ4) disesuaikan.
2026-11-07 BOM: baut M6 dan M2,5 dibeli 31 Okt. 2026
    Catat flange bolt M6 x 25 A2-70 + ring plat M6 dan baut M2,5 x 14 + mur
    + ring di tabel BOM hub; tanggal beli 31 Okt. 2026 (bukan 1 Nov.);
    zip tie klem kabel ternyata belum dibeli; ukuran baut PCB dan tiang
    housing elektronik dipastikan M2,5.
2026-11-07 Housing grip v15: pelat 140 x 35 x 8, celah 3,0
    Pelat diganti dari 170 x 30 x 10 menjadi 140 x 35 x 8 (harga per cm2,
    berat, lebar mengikuti spacer 34). HL9 dihitung ulang: lenturan ujung
    jauh 0,64 mm, jadi celah (tebal spacer) naik ke 3,0 mm, sisa celah
    0,56 mm; tegangan berlubang batas atas 121 MPa (faktor aman 2,0), jadi
    8 mm adalah tebal minimum; ulir masuk 12,4 mm, baut maksimal M6 x 30.
    CSV, instruksi kerja Fusion v8, asumsi.md, hub, dan dokumen terkait
    menyesuaikan. Gambar baru tampak_atas_housing_grip.svg (berskala).
    HL4 butir 5 diganti uraian klem zip tie; HL10 mencatat slot alas
    kalibrasi terlalu kecil untuk flange bolt.
2026-11-08 Housing grip v16: lebar pelat 40 (140 x 40 x 8)
    Lebar 35 menjadi 40: faktor aman penampang berlubang (batas atas) naik
    dari 1,98 ke 2,4, lenturan ujung jauh 0,558 mm, sisa celah 0,64 mm;
    pelat menutup spacer penuh. Pesanan 2 lembar 14 x 4 cm (112 cm2,
    sekitar Rp40.880). HL11: tandai lubang dari garis tengah hasil ukur dan
    kikir tepi. CSV bar_W 40, instruksi kerja v9, gambar tampak atas v16.
2026-11-08 Gambar housing grip digambar ulang dari CSV (v16)
    Lima gambar Cowork lama (pelat 10 mm, spacer 28, klem blok lama, tidak
    berskala) diganti gambar berskala yang dibaca dari CSV parameter:
    potongan memanjang, exploded isometrik, tampak depan dan potongan A-A
    klem kabel (takik + zip tie, potongan di sumbu kabel), dan setup
    kalibrasi tahap 1. Nomor callout lama dipertahankan. Setup kalibrasi
    menandai bahwa alas karet 6 mm lebih tipis dari kepala flange bolt.
    Teks yang merujuk gambar (desain v17, asumsi, protokol) disesuaikan.
2026-11-08 Skrip generate_drawings.py untuk gambar housing grip
    Skrip Python (pustaka standar saja) membaca CSV parameter grip dan
    menggambar ulang enam SVG: potongan memanjang, exploded isometrik, dua
    tampak klem kabel, tampak atas, dan setup kalibrasi. Tampak atas kini
    juga dibaca dari CSV (sebelumnya angka tetap). Cara menjalankan dicatat
    di HL12.
2026-11-09 Pelat housing grip: 6061-T6 dikonfirmasi penjual
    Paduan dan temper pelat (6061-T6) dikonfirmasi penjual, sama dengan
    nilai yang dipakai di hitungan HL9. HL11 mencatat bahwa temper ikut
    menentukan (T4 hampir tidak lolos, O gagal); hub BOM diperbarui.
2026-11-09 Rapikan sisa info housing lama di repo
    README, status dan anggaran di hub (terpakai Rp272.669, sisa Rp27.331),
    langkah berikutnya, versi dokumen housing (v17), catatan alas kalibrasi
    di alur program, dan daftar asumsi klem disesuaikan dengan desain v17
    (pelat 140 x 40 x 8, flange bolt, klem zip tie). Tabel pengukuran: hasil
    ukur load cell C2, C3, C4, C6 dan posisi kabel C7 diisi; tab baut dan
    pelat diganti ke part yang dibeli/dipesan.
2026-11-11 Firmware: rapikan komentar usang pasca-UTS (tanpa ubah kode)
    Teks layar ulangan tare jendela offset di komentar kini "Nol ulang:
    lepas" (config.h, sensor.h, sensor.cpp); format baris E di fault.h
    memuat kolom boot; komentar LED di enterRest() menjelaskan jalur yang
    benar (batas 5 s saat stabil); kepala fsm.cpp dan hgd.ino menjadi
    ringkasan perilaku sekarang, bukan riwayat langkah; rujukan "firmware
    tim lainnya" dihapus. Kode tanpa komentar identik; build PlatformIO
    berhasil.
2026-11-12 PCB 12 Nov.: silkscreen footprint dirapikan, D2 digeser, Gerber dicek ulang
    - Papan dan proyek KiCad dari revisi 12 Nov. 2026: garis silkscreen
    footprint D1, D2, R1, R2 yang terlalu dekat pad dihapus; D2 digeser
    0,52 mm (segaris SW1) dengan dua segmen jalur GND; tiga via jahit GND
    di tepi bawah digeser; uji beda-pustaka diatur ignore. Folder keluaran
    dikembalikan ke gerber/ dan hgd-v1.step.
    - ERC dan DRC ulang 0 error; JLCDFM: silkscreen ke pad 0 temuan.
    - Gambar penempatan: D2, jalur, via, dan pour GND dari papan baru.
    - Desain PCB v9, log kerja KiCad v3, README KiCad v7, catatan v61.
    - Housing elektronik v8: lubang LED D2 di lid perlu pindah ke x -15,0.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
2026-11-12 PCB: title block Revision 2 (12 Nov. 2026), Gerber dikumpulkan ulang
    Papan hanya berubah di title block (rev 1 -> 2, tanggal 2026-11-12);
    geometri sama dengan papan 12 Nov. Catatan ekspor 11:14 dan
    pengumpulan ulang di desain PCB dan log kerja KiCad.
